ammolytics/ballistic-daq/acquisition/board/acquisition.kicad_pcb

## KiCad design acquisition/board/acquisition.kicad_pcb (2023-02-04)

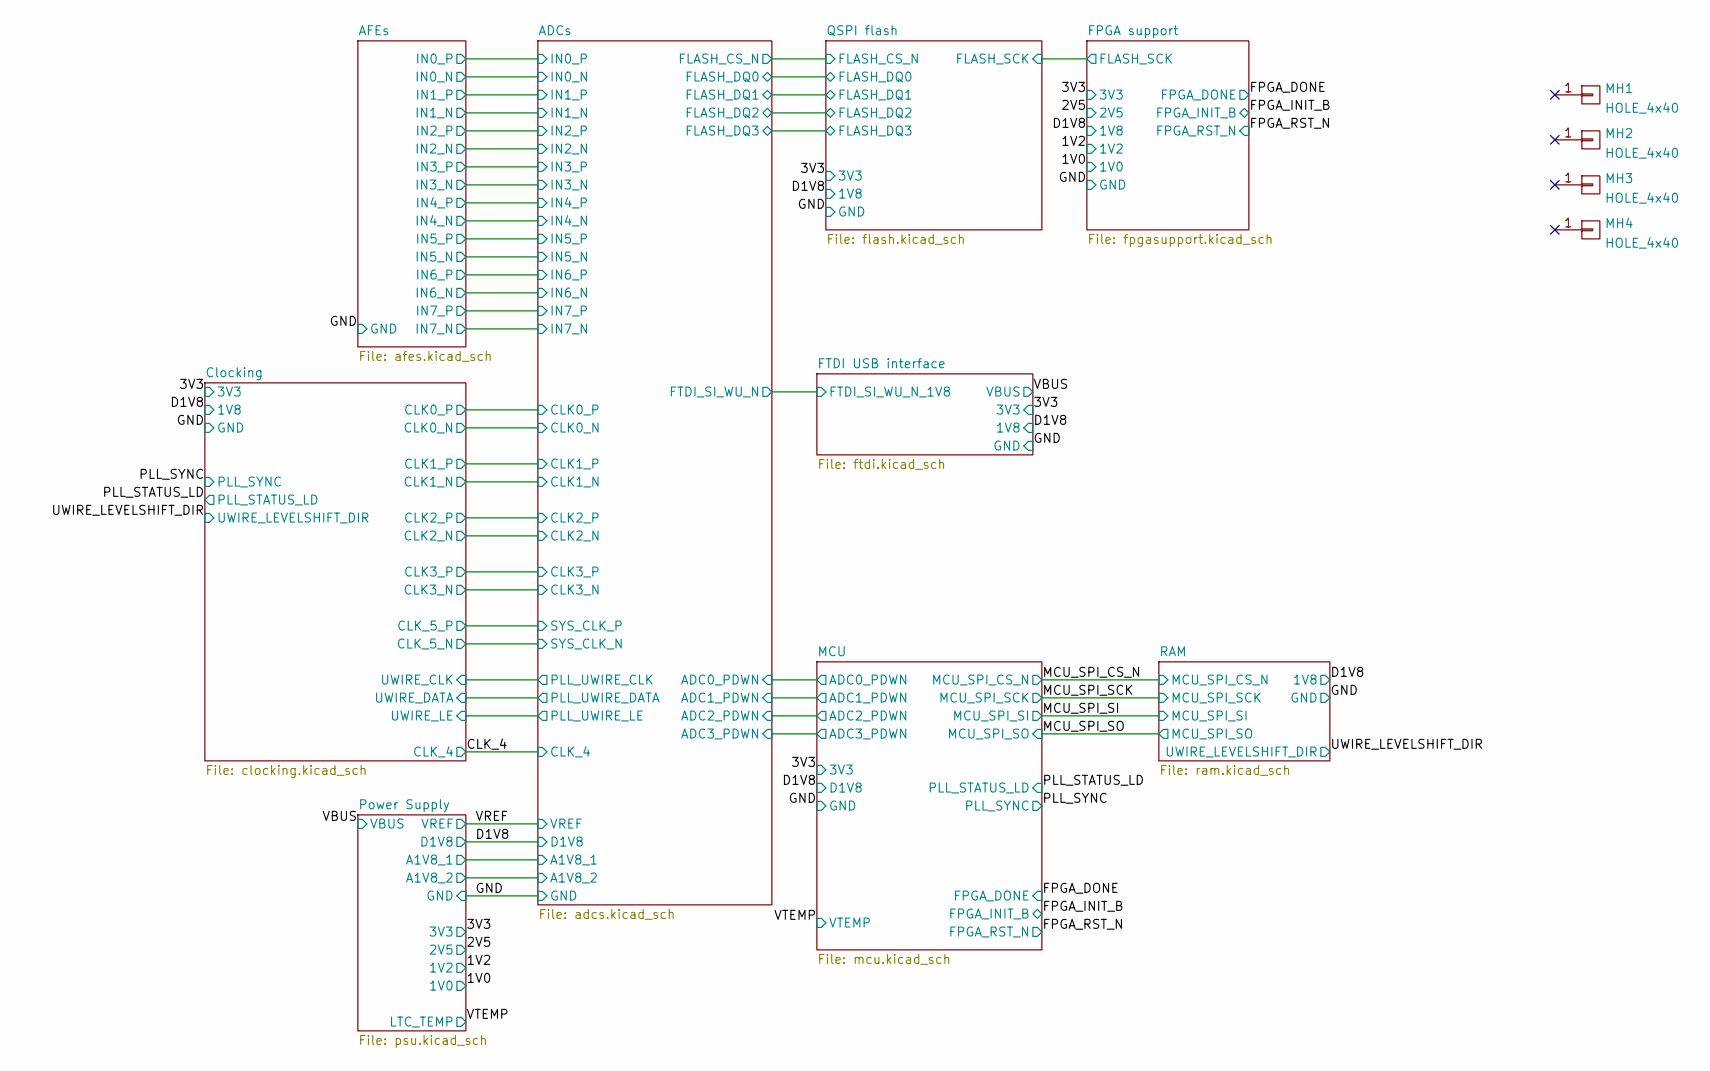
[picture p1: schematic acquisition.kicad_sch, Digitizer board]

Parts:
MH1, MH2, MH3, MH4: HOLE_4x40; MECHANICAL_CLEARANCEHOLE_4_40

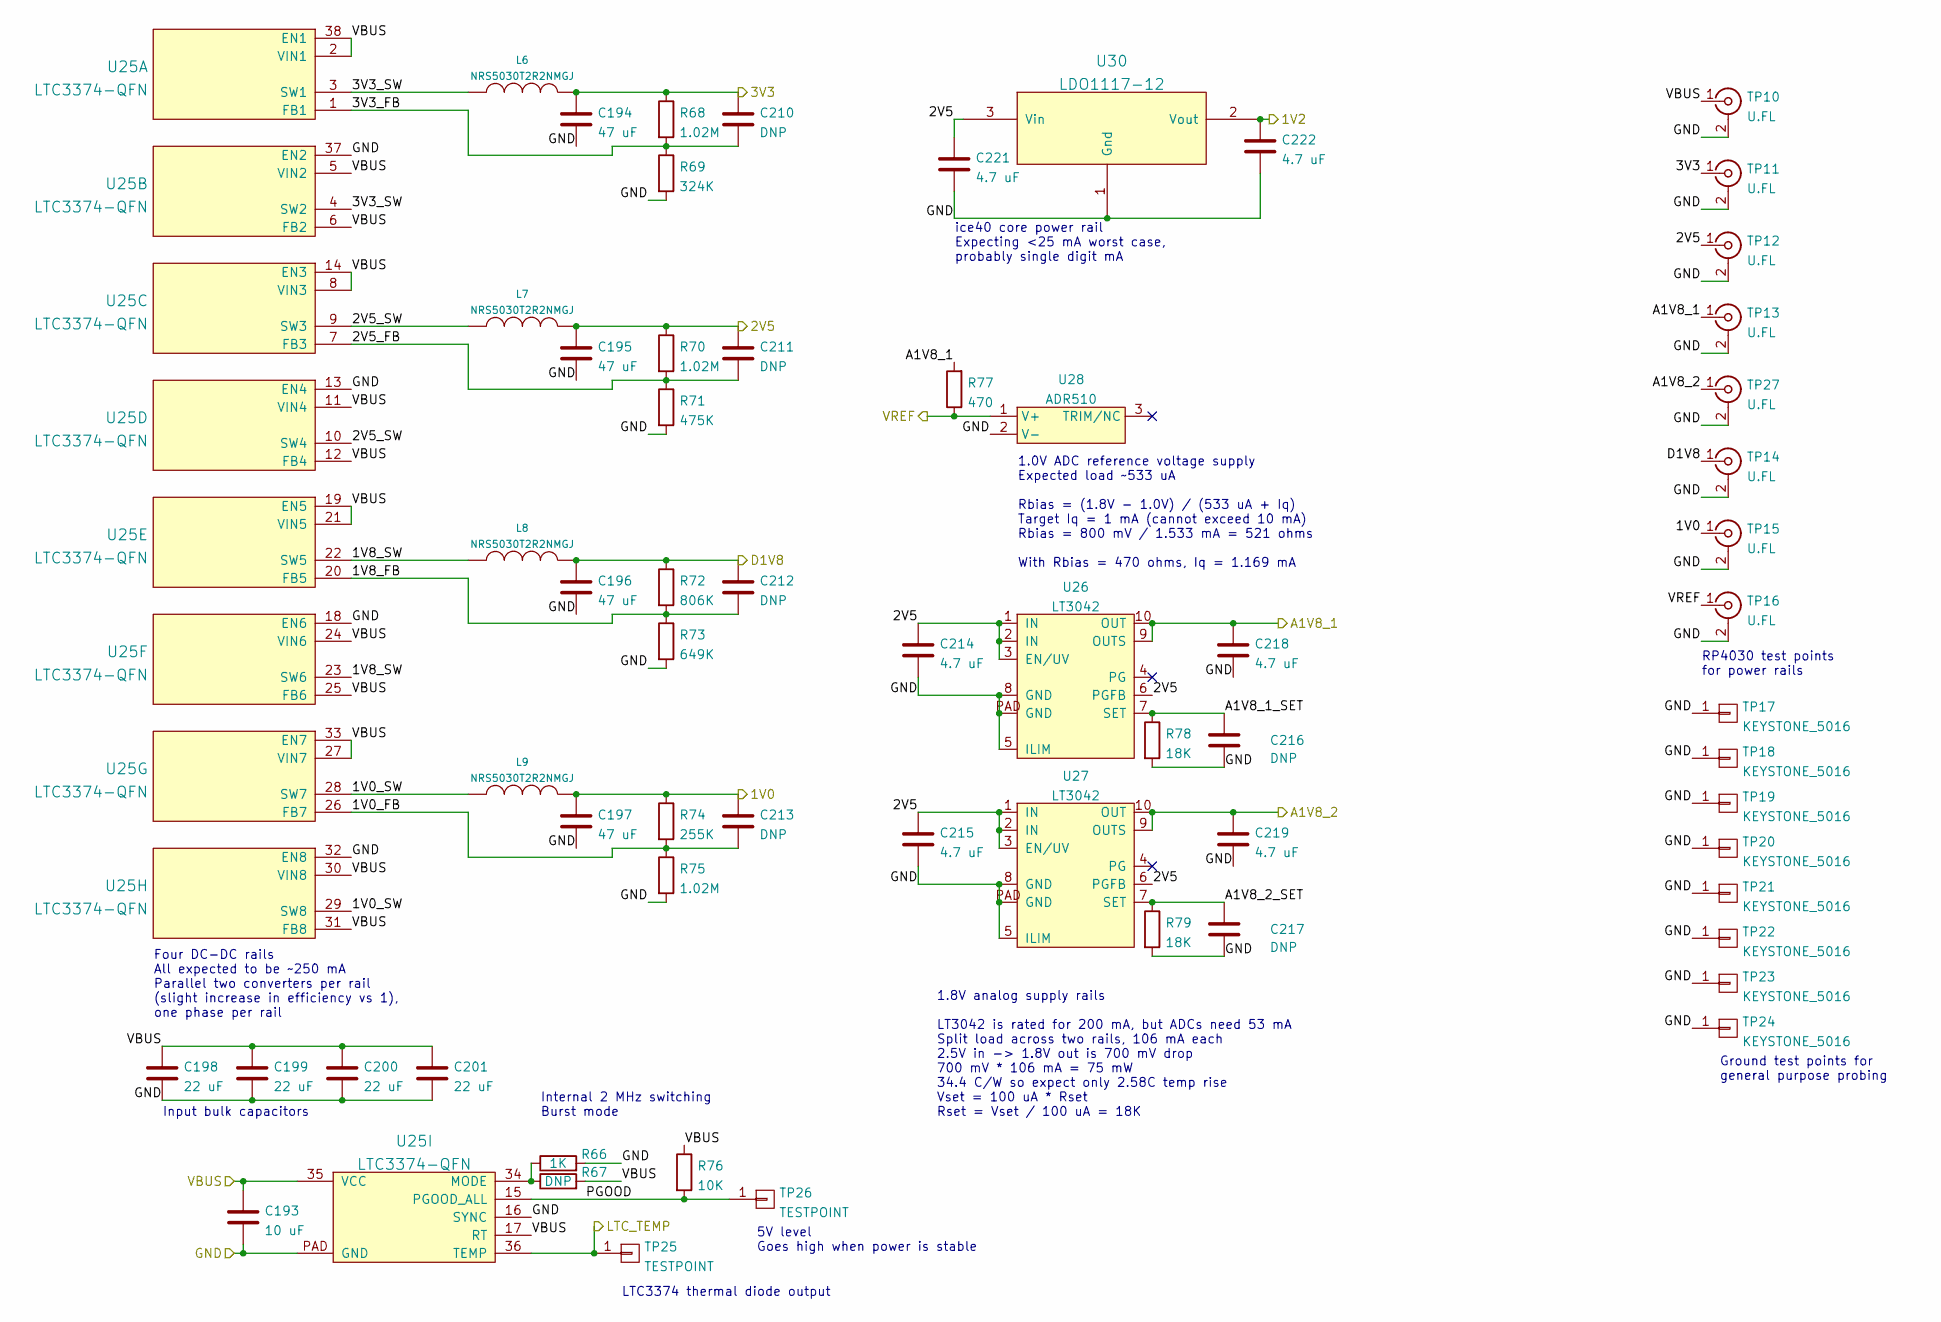
[picture p2: schematic psu.kicad_sch, Digitizer board]

Parts:
C193: 10 uF; EIA_1206_CAP_NOSILK
C194, C195, C196, C197: 47 uF; EIA_1206_CAP_NOSILK
C198, C199, C200, C201: 22 uF; EIA_1210_CAP_NOSILK
C210, C211, C212, C213, C216, C217: DNP; EIA_0402_CAP_NOSILK
C214, C215, C218, C219, C221, C222: 4.7 uF; EIA_0603_CAP_NOSILK
L6, L7, L8, L9: NRS5030T2R2NMGJ; INDUCTOR_YUDEN_NRS5030
R66: 1K; EIA_0402_RES_NOSILK
R67: DNP; EIA_0402_RES_NOSILK
R68, R70, R75: 1.02M; EIA_0402_RES_NOSILK
R69: 324K; EIA_0402_RES_NOSILK
R71: 475K; EIA_0402_RES_NOSILK
R72: 806K; EIA_0402_RES_NOSILK
R73: 649K; EIA_0402_RES_NOSILK
R74: 255K; EIA_0402_RES_NOSILK
R76: 10K; EIA_0402_RES_NOSILK
R77: 470; EIA_0402_RES_NOSILK
R78, R79: 18K; EIA_0402_RES_NOSILK
TP10, TP11, TP12, TP13, TP14, TP15, TP16, TP27: U.FL; CONN_U.FL_TE_1909763-1
TP17, TP18, TP19, TP20, TP21, TP22, TP23, TP24: KEYSTONE_5016; TESTPOINT_SMT_KEYSTONE_5016
TP25, TP26: TESTPOINT; TESTPOINT_SMT_0.5MM
U25: LTC3374-QFN; QFN_38_0.5MM_5x7MM
U26, U27: LT3042; DFN_10_0.5MM_3x3MM
U28: ADR510; SOT23_3
U30: LDO1117-12; SOT223-4

Connections:
/1V0: C197.1, C213.1, L9.1, R74.1, TP15.1 (In); also elsewhere on the board
/1V2: C222.1, U30.2 (Vout); also elsewhere on the board
/2V5: C195.1, C211.1, C214.1, C215.1, C221.1, L7.1, R70.1, TP12.1 (In), U26.1 (IN), U26.2 (IN), U26.3 (EN/UV), U26.6 (PGFB), U27.1 (IN), U27.2 (IN), U27.3 (EN/UV), U27.6 (PGFB), U30.3 (Vin); also elsewhere on the board
/3V3: C194.1, C210.1, L6.1, R68.1, TP11.1 (In); also elsewhere on the board
/ADCs/A1V8_1: C218.1, R77.2, TP13.1 (In), U26.9 (OUTS), U26.10 (OUT); also elsewhere on the board
/ADCs/A1V8_2: C219.1, TP27.1 (In), U27.9 (OUTS), U27.10 (OUT); also elsewhere on the board
/D1V8: C196.1, C212.1, L8.1, R72.1, TP14.1 (In); also elsewhere on the board
/GND: C193.2, C194.2, C195.2, C196.2, C197.2, C198.2, C199.2, C200.2, C201.2, C214.2, C215.2, C216.2, C217.2, C218.2, C219.2, C221.2, C222.2, R66.2, R69.2, R71.2, R73.2, R75.2, R78.2, R79.2, TP10.2 (Ext), TP11.2 (Ext), TP12.2 (Ext), TP13.2 (Ext), TP14.2 (Ext), TP15.2 (Ext), TP16.2 (Ext), TP17.1, TP18.1, TP19.1, TP20.1, TP21.1, TP22.1, TP23.1, TP24.1, TP27.2 (Ext), U25.13 (EN4), U25.16 (SYNC), U25.18 (EN6), U25.32 (EN8), U25.37 (EN2), U25.PAD (GND), U26.5 (ILIM), U26.8 (GND), U26.PAD (GND), U27.5 (ILIM), U27.8 (GND), U27.PAD (GND), U28.2 (V-), U30.1 (Gnd); also elsewhere on the board
/Power Supply/1V0_FB: C213.2, R74.2, R75.1, U25.26 (FB7)
/Power Supply/1V0_SW: L9.2, U25.28 (SW7), U25.29 (SW8)
/Power Supply/1V8_FB: C212.2, R72.2, R73.1, U25.20 (FB5)
/Power Supply/1V8_SW: L8.2, U25.22 (SW5), U25.23 (SW6)
/Power Supply/2V5_FB: C211.2, R70.2, R71.1, U25.7 (FB3)
/Power Supply/2V5_SW: L7.2, U25.9 (SW3), U25.10 (SW4)
/Power Supply/3V3_FB: C210.2, R68.2, R69.1, U25.1 (FB1)
/Power Supply/3V3_SW: L6.2, U25.3 (SW1), U25.4 (SW2)
/Power Supply/A1V8_1_SET: C216.1, R78.1, U26.7 (SET)
/Power Supply/A1V8_2_SET: C217.1, R79.1, U27.7 (SET)
/Power Supply/PGOOD: R76.2, TP26.1, U25.15 (PGOOD_ALL)
/VBUS: C193.1, C198.1, C199.1, C200.1, C201.1, R67.2, R76.1, TP10.1 (In), U25.2 (VIN1), U25.5 (VIN2), U25.6 (FB2), U25.8 (VIN3), U25.11 (VIN4), U25.12 (FB4), U25.14 (EN3), U25.17 (RT), U25.19 (EN5), U25.21 (VIN5), U25.24 (VIN6), U25.25 (FB6), U25.27 (VIN7), U25.30 (VIN8), U25.31 (FB8), U25.33 (EN7), U25.35 (VCC), U25.38 (EN1); also elsewhere on the board
/VREF: R77.1, TP16.1 (In), U28.1 (V+); also elsewhere on the board
/VTEMP: TP25.1, U25.36 (TEMP); also elsewhere on the board
unnamed: R66.1, R67.1, U25.34 (MODE)

Notes on the sheet:
ice40 core power rail Expecting <25 mA worst case, probably single digit mA
LTC3374 thermal diode output
Ground test points for general purpose probing
5V level Goes high when power is stable
Input bulk capacitors
1.8V analog supply rails LT3042 is rated for 200 mA, but ADCs need 53 mA Split load across two rails, 106 mA each 2.5V in -> 1.8V out is 700 mV drop 700 mV * 106 mA = 75 mW 34.4 C/W so expect only 2.58C temp rise Vset = 100 uA * Rset Rset = Vset / 100 uA = 18K
Internal 2 MHz switching Burst mode
RP4030 test points for power rails
Four DC-DC rails All expected to be ~250 mA Parallel two converters per rail (slight increase in efficiency vs 1), one phase per rail
1.0V ADC reference voltage supply Expected load ~533 uA Rbias = (1.8V - 1.0V) / (533 uA + Iq) Target Iq = 1 mA (cannot exceed 10 mA) Rbias = 800 mV / 1.533 mA = 521 ohms With Rbias = 470 ohms, Iq = 1.169 mA

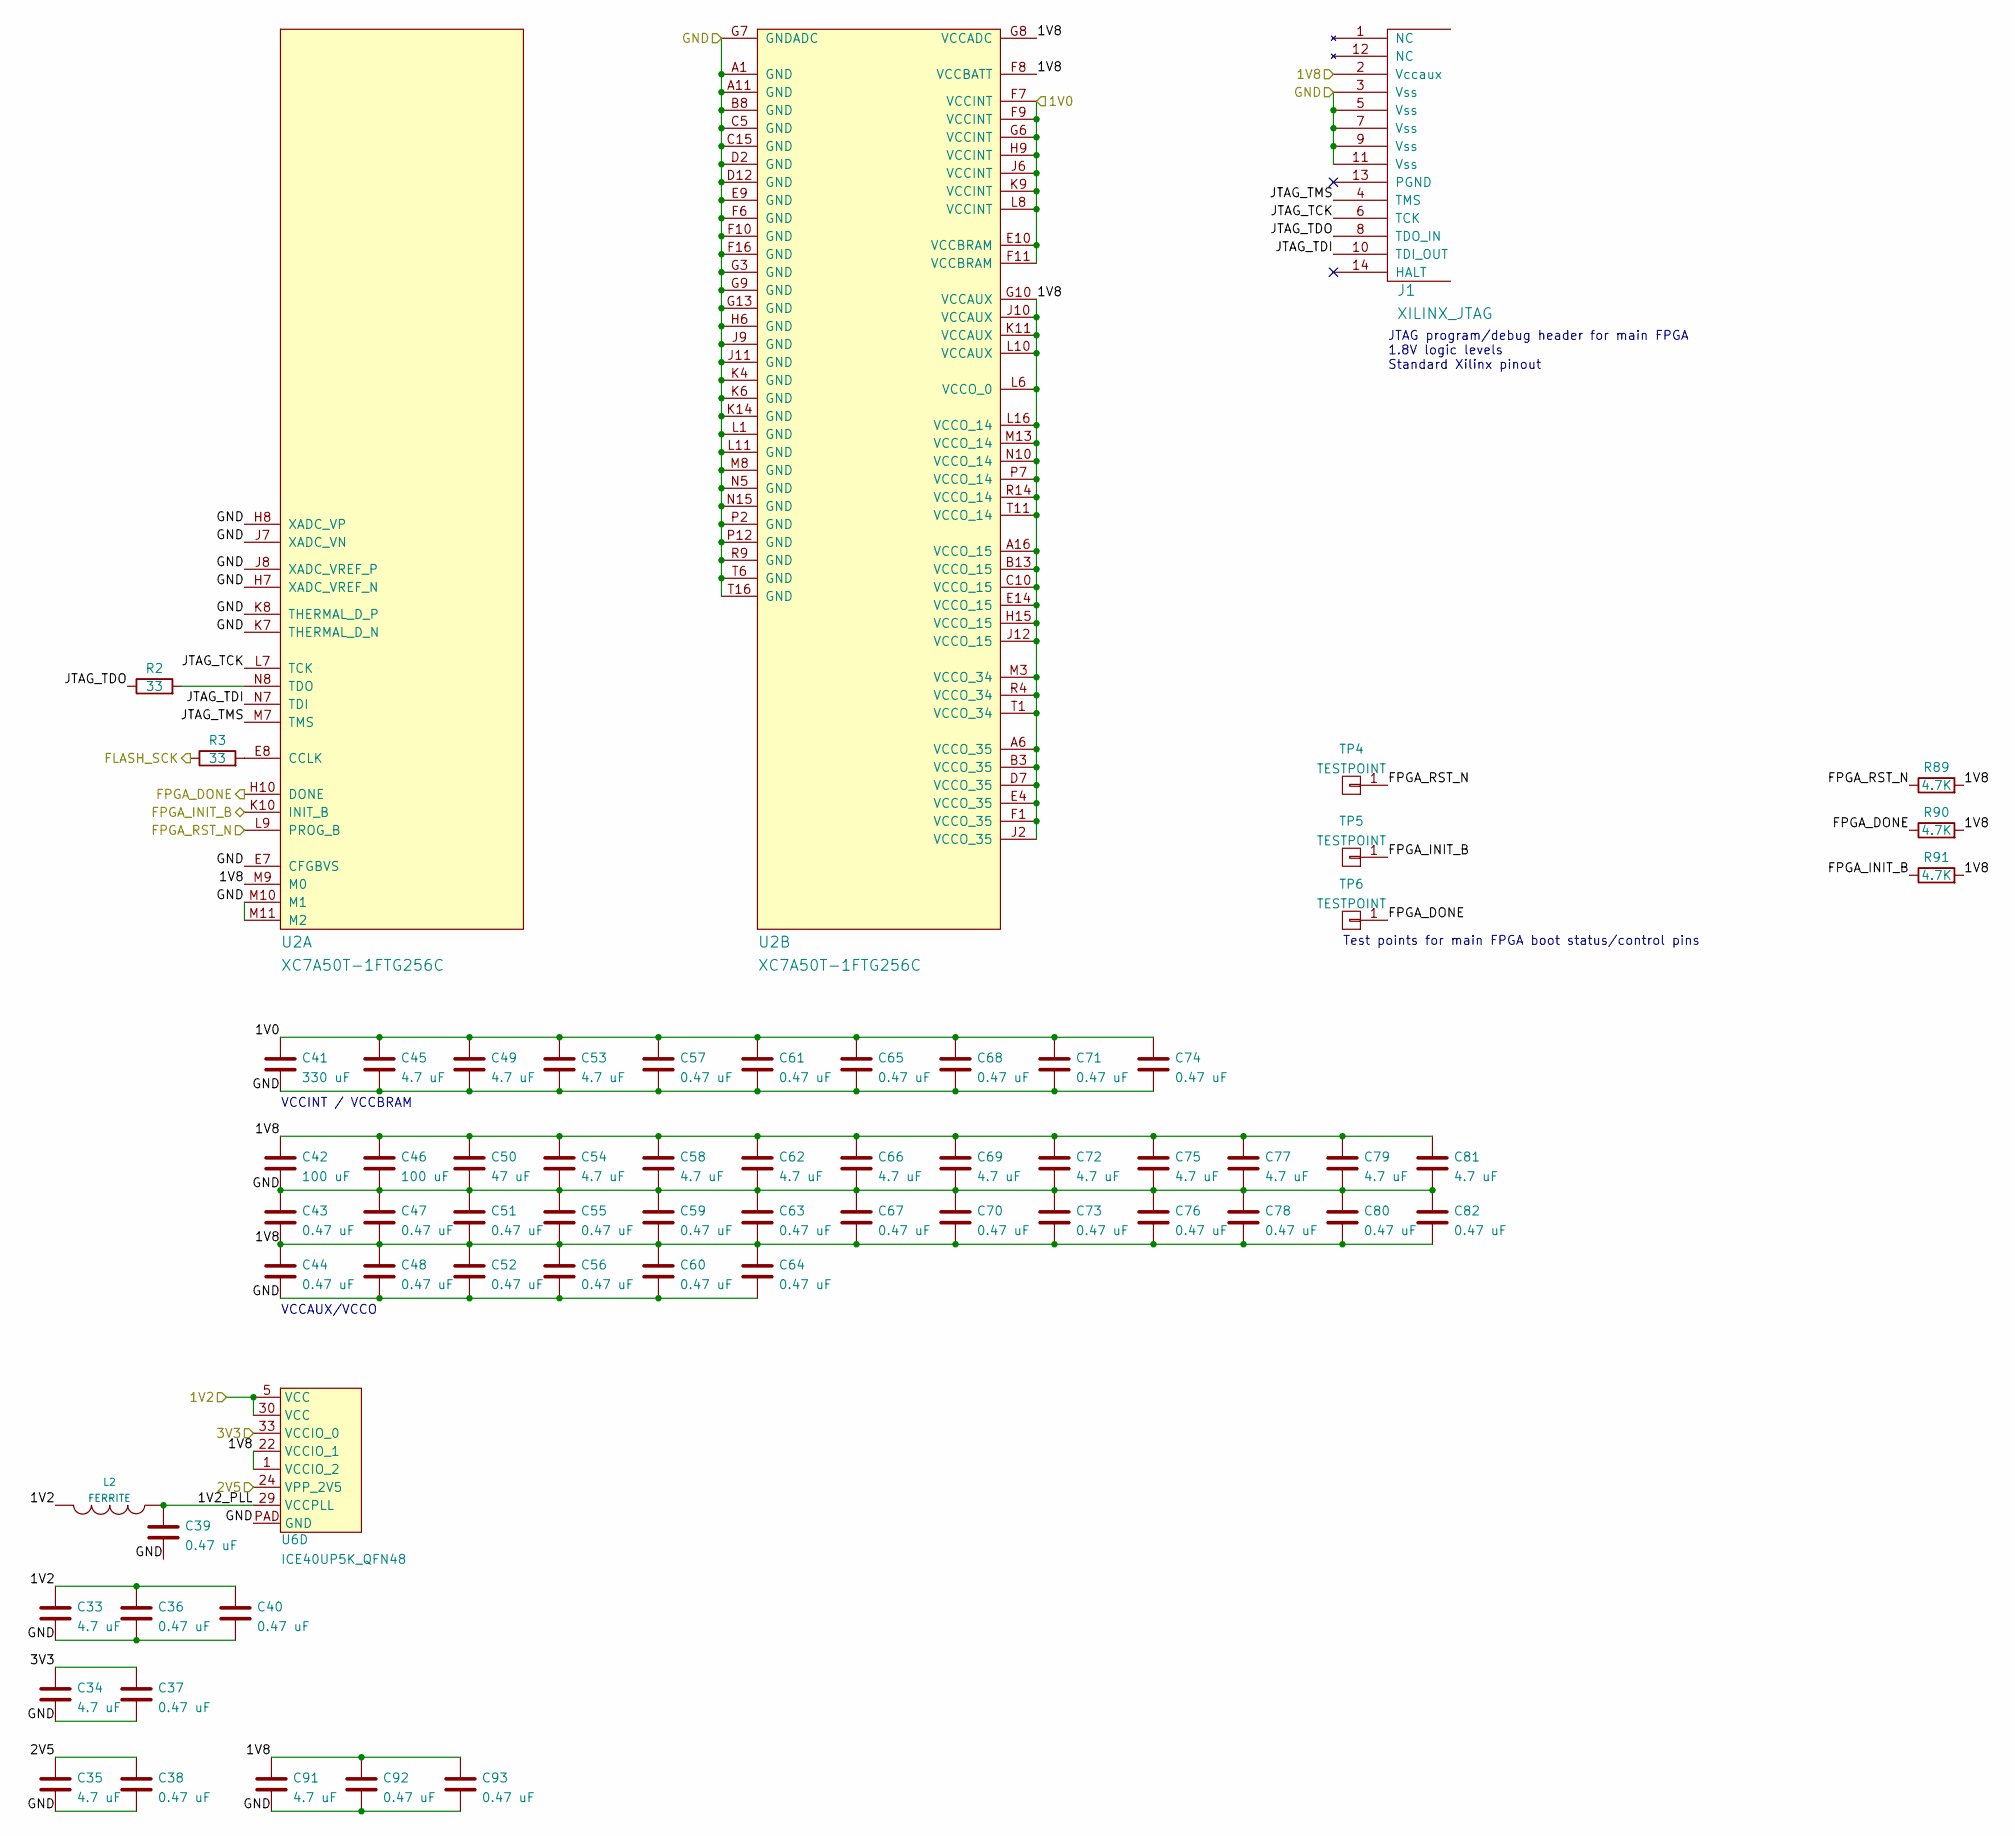
[picture p3: schematic fpgasupport.kicad_sch, Digitizer board]

Parts:
C33, C34, C35, C45, C49, C53, C54, C58, C62, C66, C69, C72, C75, C77, C79, C81, C91: 4.7 uF; EIA_0603_CAP_NOSILK
C36, C37, C38, C39, C40, C43, C44, C47, C48, C51, C52, C55, C56, C57, C59, C60, C61, C63, C64, C65, C67, C68, C70, C71, C73, C74, C76, C78, C80, C82, C92, C93: 0.47 uF; EIA_0402_CAP_NOSILK
C41: 330 uF; EIA_1210_CAP_NOSILK
C42, C46: 100 uF; EIA_1206_CAP_NOSILK
C50: 47 uF; EIA_1210_CAP_NOSILK
J1: XILINX_JTAG; XILINX_JTAG_PTH_MOLEX_0878311420
L2: FERRITE; EIA_0603_INDUCTOR_NOSILK
R2, R3: 33; EIA_0402_RES_NOSILK
R89, R90, R91: 4.7K; EIA_0402_RES_NOSILK
TP4, TP5, TP6: TESTPOINT; TESTPOINT_SMT_0.5MM
U2: XC7A50T-1FTG256C; BGA_256_17x17_FULLARRAY_1MM_0.4MM_FTG256
U6: ICE40UP5K_QFN48; QFN_48_0.5MM_7x7MM

Connections:
/1V0: C41.1, C45.1, C49.1, C53.1, C57.1, C61.1, C65.1, C68.1, C71.1, C74.1, U2.E10 (VCCBRAM), U2.F7 (VCCINT), U2.F9 (VCCINT), U2.F11 (VCCBRAM), U2.G6 (VCCINT), U2.H9 (VCCINT), U2.J6 (VCCINT), U2.K9 (VCCINT), U2.L8 (VCCINT); also elsewhere on the board
/1V2: C33.1, C36.1, C40.1, L2.2, U6.5 (VCC), U6.30 (VCC); also elsewhere on the board
/2V5: C35.1, C38.1, U6.24 (VPP_2V5); also elsewhere on the board
/3V3: C34.1, C37.1, U6.33 (VCCIO_0); also elsewhere on the board
/D1V8: C42.1, C43.2, C44.1, C46.1, C47.2, C48.1, C50.1, C51.2, C52.1, C54.1, C55.2, C56.1, C58.1, C59.2, C60.1, C62.1, C63.2, C64.1, C66.1, C67.2, C69.1, C70.2, C72.1, C73.2, C75.1, C76.2, C77.1, C78.2, C79.1, C80.2, C81.1, C82.2, C91.1, C92.1, C93.1, J1.2 (Vccaux), R89.2, R90.2, R91.2, U2.A6 (VCCO_35), U2.A16 (VCCO_15), U2.B3 (VCCO_35), U2.B13 (VCCO_15), U2.C10 (VCCO_15), U2.D7 (VCCO_35), U2.E4 (VCCO_35), U2.E14 (VCCO_15), U2.F1 (VCCO_35), U2.F8 (VCCBATT), U2.G8 (VCCADC), U2.G10 (VCCAUX), U2.H15 (VCCO_15), U2.J2 (VCCO_35), U2.J10 (VCCAUX), U2.J12 (VCCO_15), U2.K11 (VCCAUX), U2.L6 (VCCO_0), U2.L10 (VCCAUX), U2.L16 (VCCO_14), U2.M3 (VCCO_34), U2.M9 (M0), U2.M13 (VCCO_14), U2.N10 (VCCO_14), U2.P7 (VCCO_14), U2.R4 (VCCO_34), U2.R14 (VCCO_14), U2.T1 (VCCO_34), U2.T11 (VCCO_14), U6.1 (VCCIO_2), U6.22 (VCCIO_1); also elsewhere on the board
/FPGA support/1V2_PLL: C39.1, L2.1, U6.29 (VCCPLL)
/FPGA support/FLASH_SCK: R3.1; also elsewhere on the board
/FPGA support/JTAG_TCK: J1.6 (TCK), U2.L7 (TCK)
/FPGA support/JTAG_TDI: J1.10 (TDI_OUT), U2.N7 (TDI)
/FPGA support/JTAG_TDO: J1.8 (TDO_IN), R2.1
/FPGA support/JTAG_TMS: J1.4 (TMS), U2.M7 (TMS)
/FPGA_DONE: R90.1, TP6.1, U2.H10 (DONE); also elsewhere on the board
/FPGA_INIT_B: R91.1, TP5.1, U2.K10 (INIT_B); also elsewhere on the board
/FPGA_RST_N: R89.1, TP4.1, U2.L9 (PROG_B); also elsewhere on the board
/GND: C33.2, C34.2, C35.2, C36.2, C37.2, C38.2, C39.2, C40.2, C41.2, C42.2, C43.1, C44.2, C45.2, C46.2, C47.1, C48.2, C49.2, C50.2, C51.1, C52.2, C53.2, C54.2, C55.1, C56.2, C57.2, C58.2, C59.1, C60.2, C61.2, C62.2, C63.1, C64.2, C65.2, C66.2, C67.1, C68.2, C69.2, C70.1, C71.2, C72.2, C73.1, C74.2, C75.2, C76.1, C77.2, C78.1, C79.2, C80.1, C81.2, C82.1, C91.2, C92.2, C93.2, J1.3 (Vss), J1.5 (Vss), J1.7 (Vss), J1.9 (Vss), J1.11 (Vss), U2.A1 (GND), U2.A11 (GND), U2.B8 (GND), U2.C5 (GND), U2.C15 (GND), U2.D2 (GND), U2.D12 (GND), U2.E7 (CFGBVS), U2.E9 (GND), U2.F6 (GND), U2.F10 (GND), U2.F16 (GND), U2.G3 (GND), U2.G7 (GNDADC), U2.G9 (GND), U2.G13 (GND), U2.H6 (GND), U2.H7 (XADC_VREF_N), U2.H8 (XADC_VP), U2.J7 (XADC_VN), U2.J8 (XADC_VREF_P), U2.J9 (GND), U2.J11 (GND), U2.K4 (GND), U2.K6 (GND), U2.K7 (THERMAL_D_N), U2.K8 (THERMAL_D_P), U2.K14 (GND), U2.L1 (GND), U2.L11 (GND), U2.M8 (GND), U2.M10 (M1), U2.M11 (M2), U2.N5 (GND), U2.N15 (GND), U2.P2 (GND), U2.P12 (GND), U2.R9 (GND), U2.T6 (GND), U2.T16 (GND), U6.PAD (GND); also elsewhere on the board
unnamed: R2.2, U2.N8 (TDO)
unnamed: R3.2, U2.E8 (CCLK)

Notes on the sheet:
JTAG program/debug header for main FPGA 1.8V logic levels Standard Xilinx pinout
Test points for main FPGA boot status/control pins
VCCINT / VCCBRAM
VCCAUX/VCCO

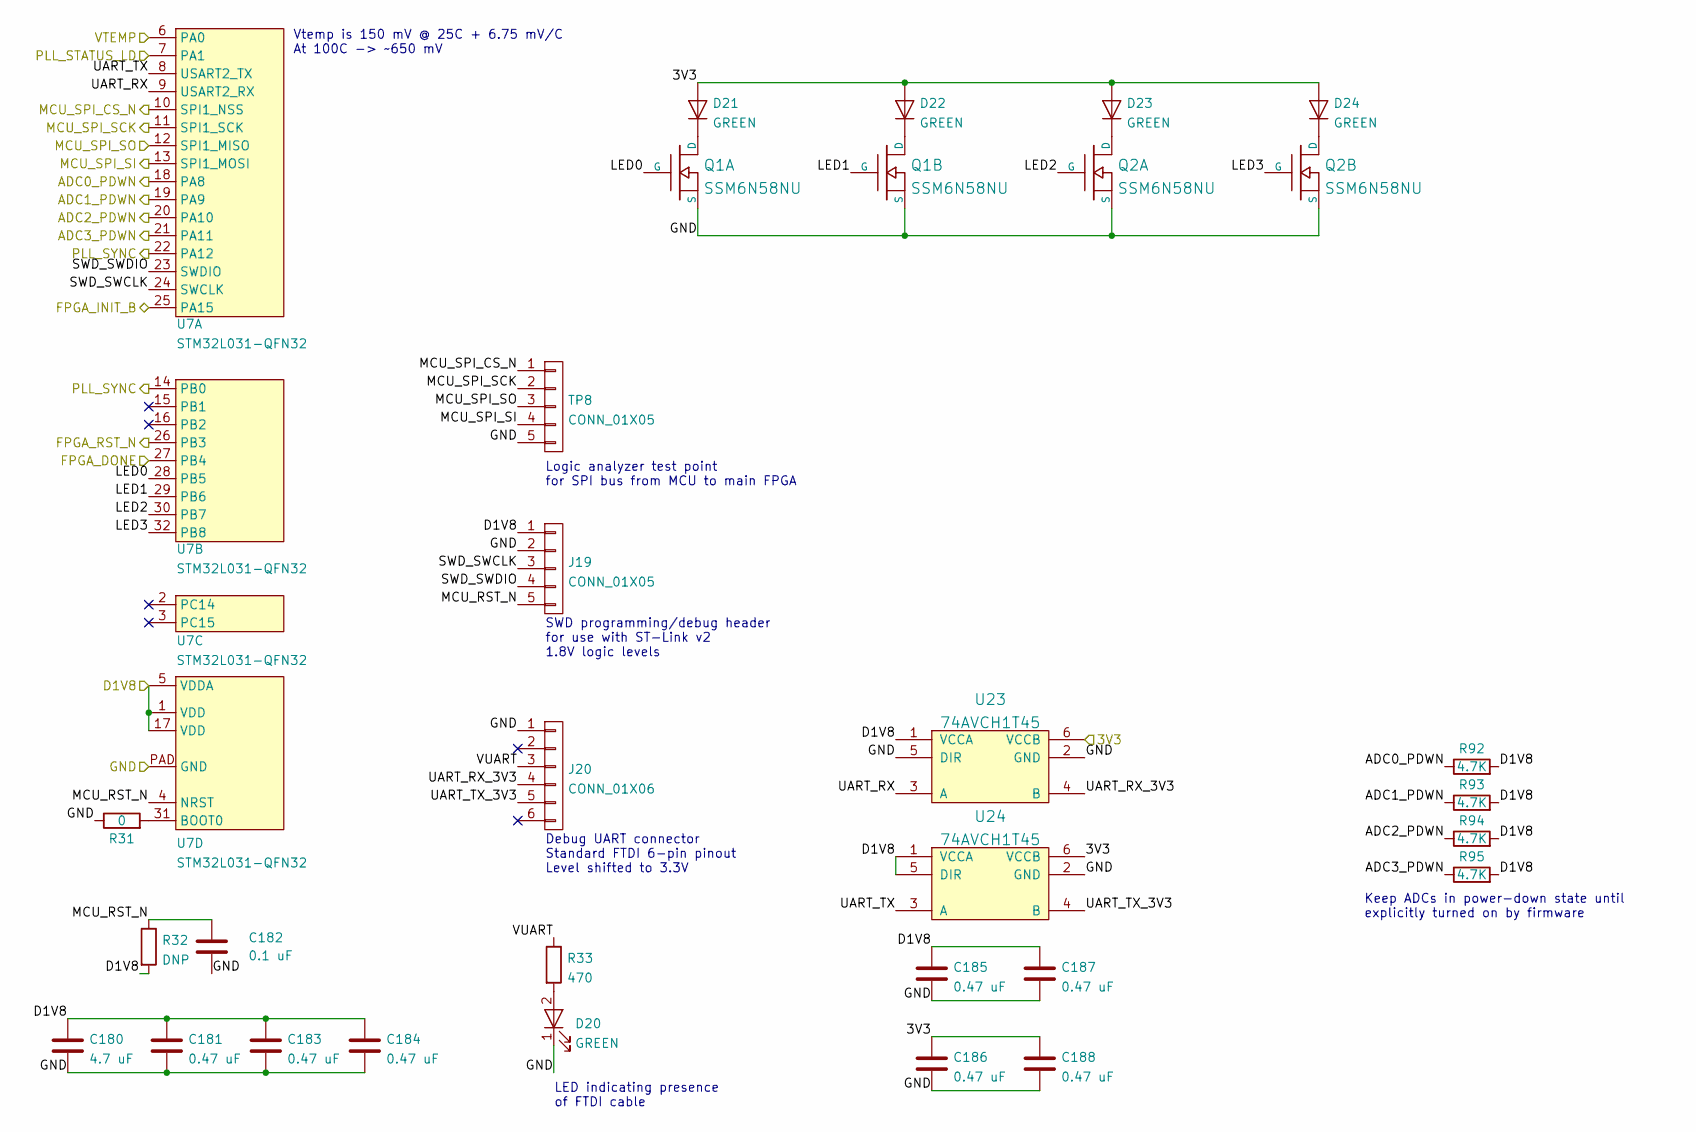
[picture p4: schematic mcu.kicad_sch, Digitizer board]

Parts:
C180: 4.7 uF; EIA_0603_CAP_NOSILK
C181, C183, C184, C185, C186, C187, C188: 0.47 uF; EIA_0402_CAP_NOSILK
C182: 0.1 uF; EIA_0402_CAP_NOSILK
D20, D21, D22, D23, D24: GREEN; EIA_0603_LED
J19: CONN_01X05; CONN_HEADER_2.54MM_1x5
J20: CONN_01X06; CONN_HEADER_2.54MM_1x6
Q1, Q2: SSM6N58NU; DFN_6_0.65MM_2x2MM_GDS
R31: 0; EIA_0402_RES_NOSILK
R32: DNP; EIA_0402_RES_NOSILK
R33: 470; EIA_0402_RES_NOSILK
R92, R93, R94, R95: 4.7K; EIA_0402_RES_NOSILK
TP8: CONN_01X05; CONN_HEADER_2.54MM_1x5
U7: STM32L031-QFN32; QFN_32_0.5MM_5x5MM
U23, U24: 74AVCH1T45; DFN_6_0.5MM_1.45x1.00MM

Connections:
/3V3: C186.1, C188.1, D21.2 (A), D22.2 (A), D23.2 (A), D24.2 (A), U23.6 (VCCB), U24.6 (VCCB); also elsewhere on the board
/D1V8: C180.1, C181.1, C183.1, C184.1, C185.1, C187.1, J19.1, R32.2, R92.2, R93.2, R94.2, R95.2, U7.1 (VDD), U7.5 (VDDA), U7.17 (VDD), U23.1 (VCCA), U24.1 (VCCA), U24.5 (DIR); also elsewhere on the board
/FPGA_DONE: U7.27 (PB4); also elsewhere on the board
/FPGA_INIT_B: U7.25 (PA15); also elsewhere on the board
/FPGA_RST_N: U7.26 (PB3); also elsewhere on the board
/GND: C180.2, C181.2, C182.2, C183.2, C184.2, C185.2, C186.2, C187.2, C188.2, D20.1 (K), J19.2, J20.1, Q1.S1 (S), Q1.S2 (S), Q2.S1 (S), Q2.S2 (S), R31.1, TP8.5, U7.PAD (GND), U23.2 (GND), U23.5 (DIR), U24.2 (GND); also elsewhere on the board
/MCU/ADC0_PDWN: R92.1, U7.18 (PA8); also elsewhere on the board
/MCU/ADC1_PDWN: R93.1, U7.19 (PA9); also elsewhere on the board
/MCU/ADC2_PDWN: R94.1, U7.20 (PA10); also elsewhere on the board
/MCU/ADC3_PDWN: R95.1, U7.21 (PA11); also elsewhere on the board
/MCU/LED0: Q1.G1 (G), U7.28 (PB5)
/MCU/LED1: Q1.G2 (G), U7.29 (PB6)
/MCU/LED2: Q2.G1 (G), U7.30 (PB7)
/MCU/LED3: Q2.G2 (G), U7.32 (PB8)
/MCU/MCU_RST_N: C182.1, J19.5, R32.1, U7.4 (NRST)
/MCU/SWD_SWCLK: J19.3, U7.24 (SWCLK)
/MCU/SWD_SWDIO: J19.4, U7.23 (SWDIO)
/MCU/UART_RX: U7.9 (USART2_RX), U23.3 (A)
/MCU/UART_RX_3V3: J20.4, U23.4 (B)
/MCU/UART_TX: U7.8 (USART2_TX), U24.3 (A)
/MCU/UART_TX_3V3: J20.5, U24.4 (B)
/MCU/VUART: J20.3, R33.1
/MCU_SPI_CS_N: TP8.1, U7.10 (SPI1_NSS); also elsewhere on the board
/MCU_SPI_SCK: TP8.2, U7.11 (SPI1_SCK); also elsewhere on the board
/MCU_SPI_SI: TP8.4, U7.13 (SPI1_MOSI); also elsewhere on the board
/MCU_SPI_SO: TP8.3, U7.12 (SPI1_MISO); also elsewhere on the board
/PLL_STATUS_LD: U7.7 (PA1); also elsewhere on the board
/PLL_SYNC: U7.14 (PB0), U7.22 (PA12); also elsewhere on the board
/VTEMP: U7.6 (PA0); also elsewhere on the board
unnamed: D20.2 (A), R33.2
unnamed: D21.1 (K), Q1.D1 (D)
unnamed: D22.1 (K), Q1.D2 (D)
unnamed: D23.1 (K), Q2.D1 (D)
unnamed: D24.1 (K), Q2.D2 (D)
unnamed: R31.2, U7.31 (BOOT0)

Notes on the sheet:
Keep ADCs in power-down state until explicitly turned on by firmware
SWD programming/debug header for use with ST-Link v2 1.8V logic levels
Debug UART connector Standard FTDI 6-pin pinout Level shifted to 3.3V
Logic analyzer test point for SPI bus from MCU to main FPGA
LED indicating presence of FTDI cable
Vtemp is 150 mV @ 25C + 6.75 mV/C At 100C -> ~650 mV
