ammolytics/ballistic-daq/acquisition/board/acquisition.kicad_pcb

## KiCad design acquisition/board/acquisition.kicad_pcb (continued)

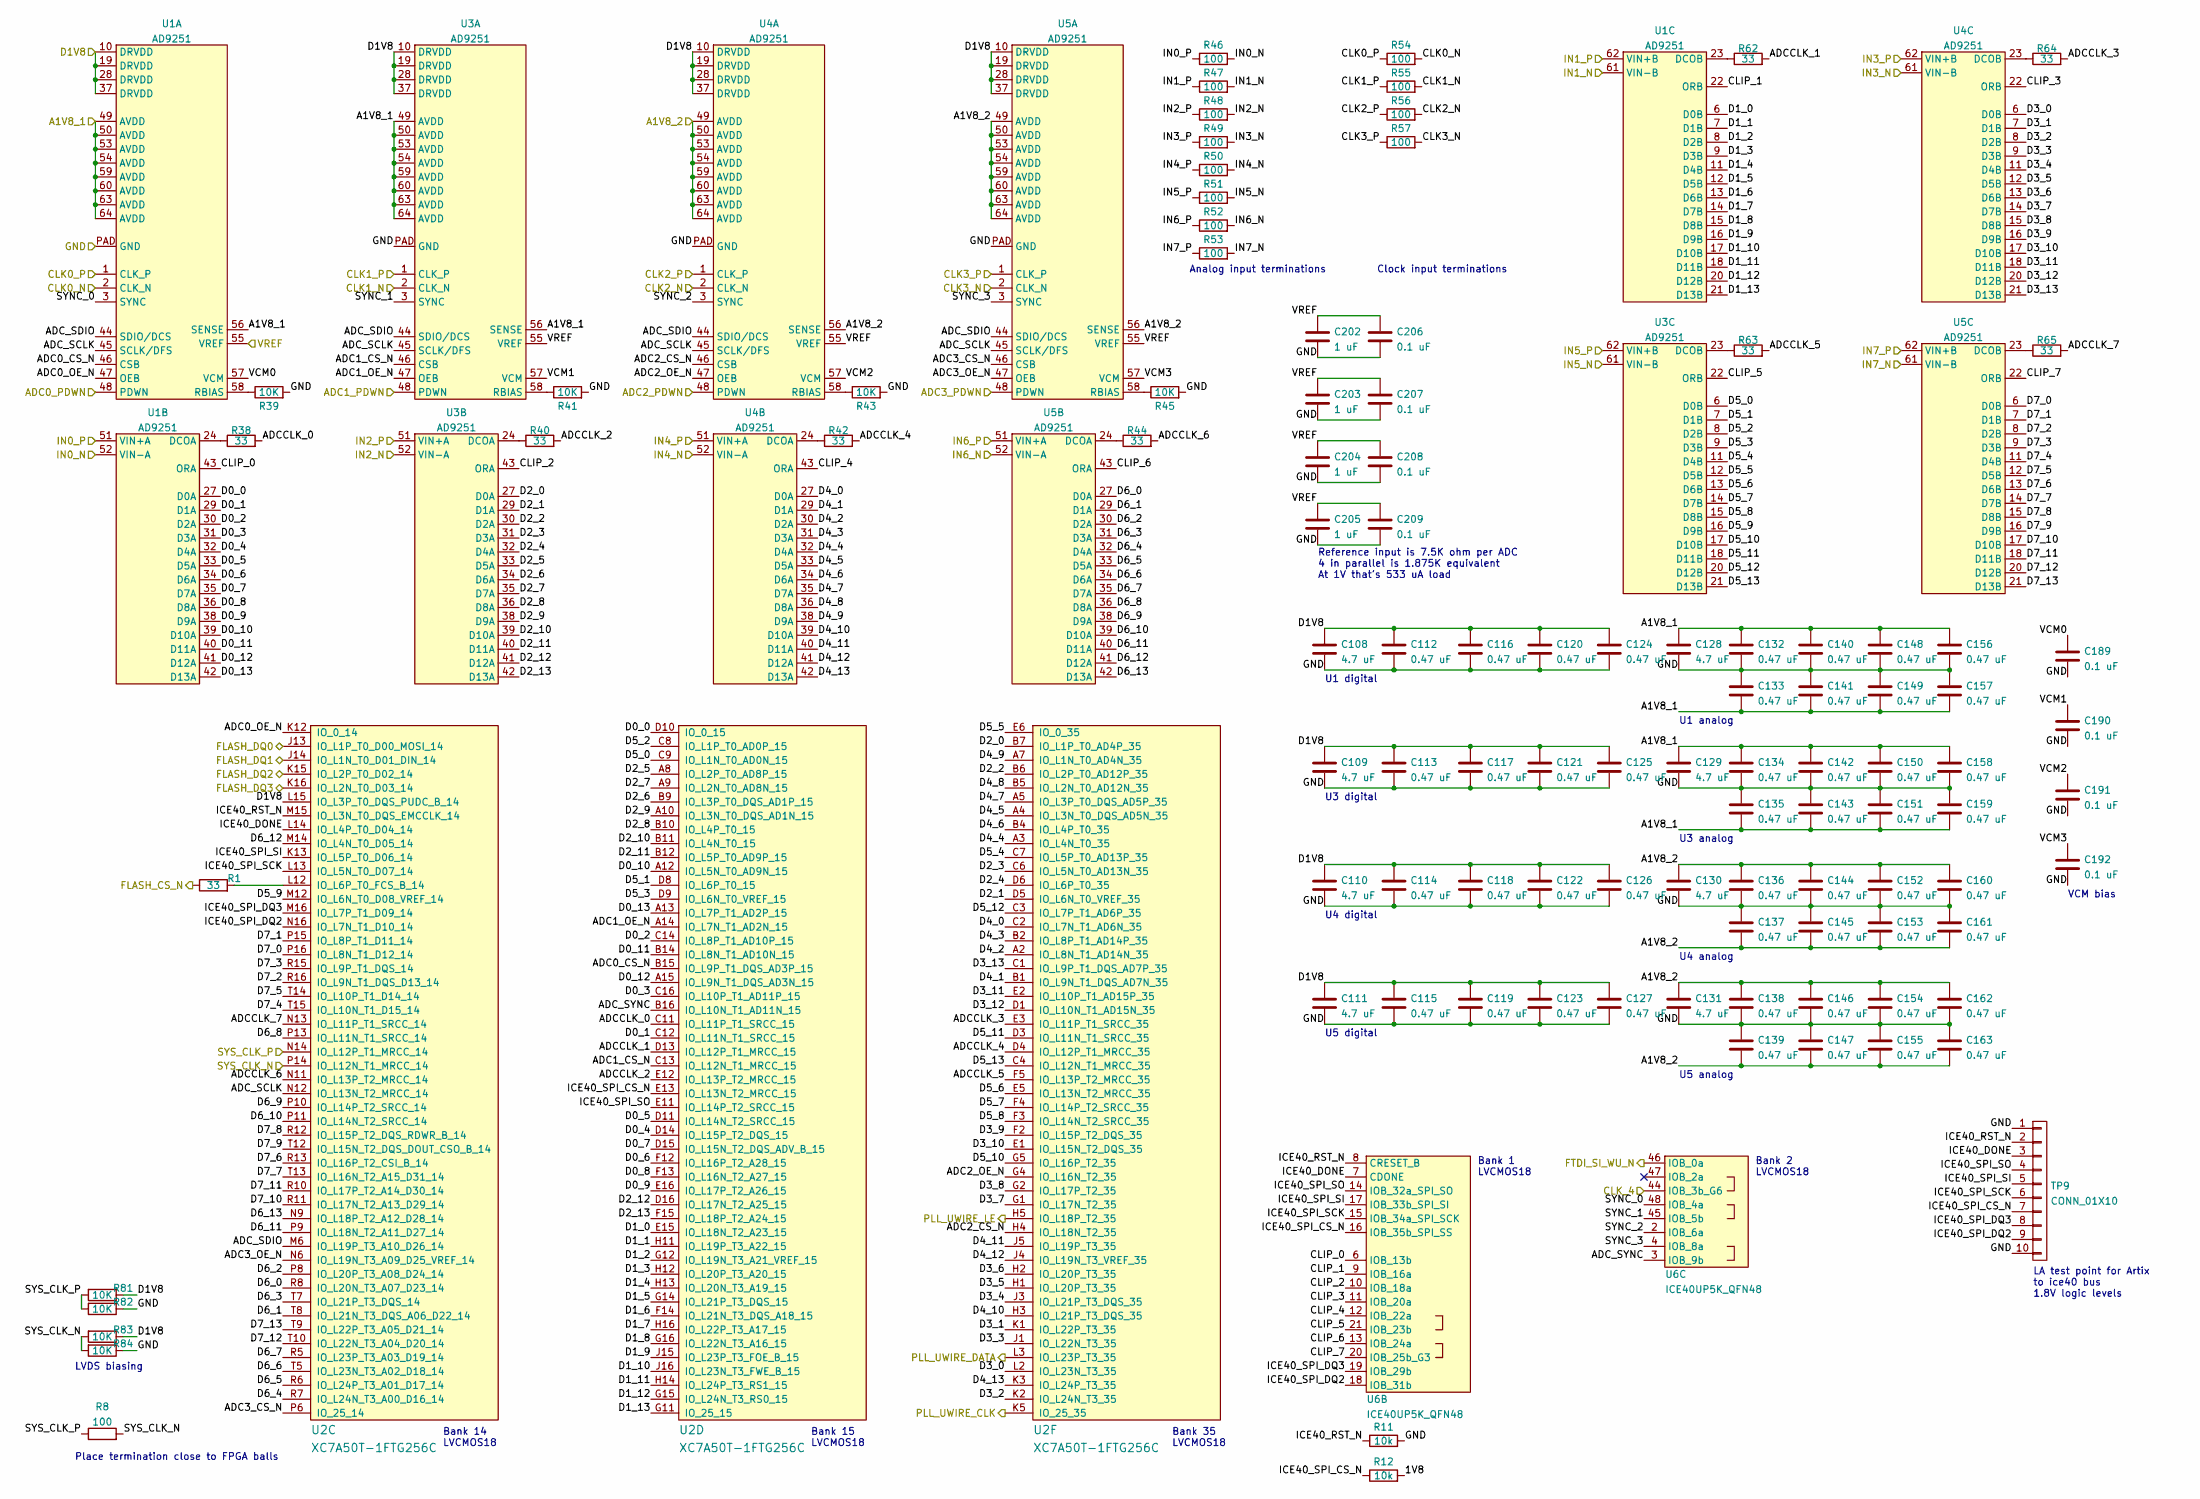
[picture p5: schematic adcs.kicad_sch, Digitizer board]

Parts:
C108, C109, C110, C111, C128, C129, C130, C131: 4.7 uF; EIA_0603_CAP_NOSILK
C112, C113, C114, C115, C116, C117, C118, C119, C120, C121, C122, C123, C124, C125, C126, C127, C132, C133, C134, C135, C136, C137, C138, C139, C140, C141, C142, C143, C144, C145, C146, C147, C148, C149, C150, C151, C152, C153, C154, C155, C156, C157, C158, C159, C160, C161, C162, C163: 0.47 uF; EIA_0402_CAP_NOSILK
C189, C190, C191, C192, C206, C207, C208, C209: 0.1 uF; EIA_0402_CAP_NOSILK
C202, C203, C204, C205: 1 uF; EIA_0603_CAP_NOSILK
R1, R38, R40, R42, R44, R62, R63, R64, R65: 33; EIA_0402_RES_NOSILK
R8, R46, R47, R48, R49, R50, R51, R52, R53, R54, R55, R56, R57: 100; EIA_0402_RES_NOSILK
R11, R12: 10k; EIA_0402_RES_NOSILK
R39, R41, R43, R45, R81, R82, R83, R84: 10K; EIA_0402_RES_NOSILK
TP9: CONN_01X10; CONN_HEADER_2.54MM_1x10
U1, U3, U4, U5: AD9251; QFN_64_0.5MM_9x9MM
U2: XC7A50T-1FTG256C; BGA_256_17x17_FULLARRAY_1MM_0.4MM_FTG256
U6: ICE40UP5K_QFN48; QFN_48_0.5MM_7x7MM

Connections:
/ADCs/1V8: R12.2
/ADCs/A1V8_1: C128.1, C129.1, C132.1, C133.2, C134.1, C135.2, C140.1, C141.2, C142.1, C143.2, C148.1, C149.2, C150.1, C151.2, C156.1, C157.2, C158.1, C159.2, U1.49 (AVDD), U1.50 (AVDD), U1.53 (AVDD), U1.54 (AVDD), U1.56 (SENSE), U1.59 (AVDD), U1.60 (AVDD), U1.63 (AVDD), U1.64 (AVDD), U3.49 (AVDD), U3.50 (AVDD), U3.53 (AVDD), U3.54 (AVDD), U3.56 (SENSE), U3.59 (AVDD), U3.60 (AVDD), U3.63 (AVDD), U3.64 (AVDD); also elsewhere on the board
/ADCs/A1V8_2: C130.1, C131.1, C136.1, C137.2, C138.1, C139.2, C144.1, C145.2, C146.1, C147.2, C152.1, C153.2, C154.1, C155.2, C160.1, C161.2, C162.1, C163.2, U4.49 (AVDD), U4.50 (AVDD), U4.53 (AVDD), U4.54 (AVDD), U4.56 (SENSE), U4.59 (AVDD), U4.60 (AVDD), U4.63 (AVDD), U4.64 (AVDD), U5.49 (AVDD), U5.50 (AVDD), U5.53 (AVDD), U5.54 (AVDD), U5.56 (SENSE), U5.59 (AVDD), U5.60 (AVDD), U5.63 (AVDD), U5.64 (AVDD); also elsewhere on the board
/ADCs/ADC0_CS_N: U1.46 (CSB), U2.B15 (IO_L9P_T1_DQS_AD3P_15)
/ADCs/ADC0_OE_N: U1.47 (OEB), U2.K12 (IO_0_14)
/ADCs/ADC1_CS_N: U2.C13 (IO_L12N_T1_MRCC_15), U3.46 (CSB)
/ADCs/ADC1_OE_N: U2.A14 (IO_L7N_T1_AD2N_15), U3.47 (OEB)
/ADCs/ADC2_CS_N: U2.H4 (IO_L18N_T2_35), U4.46 (CSB)
/ADCs/ADC2_OE_N: U2.G4 (IO_L16N_T2_35), U4.47 (OEB)
/ADCs/ADC3_CS_N: U2.P6 (IO_25_14), U5.46 (CSB)
/ADCs/ADC3_OE_N: U2.N6 (IO_L19N_T3_A09_D25_VREF_14), U5.47 (OEB)
/ADCs/ADCCLK_0: R38.2, U2.C11 (IO_L11P_T1_SRCC_15)
/ADCs/ADCCLK_1: R62.2, U2.D13 (IO_L12P_T1_MRCC_15)
/ADCs/ADCCLK_2: R40.2, U2.E12 (IO_L13P_T2_MRCC_15)
/ADCs/ADCCLK_3: R64.2, U2.E3 (IO_L11P_T1_SRCC_35)
/ADCs/ADCCLK_4: R42.2, U2.D4 (IO_L12P_T1_MRCC_35)
/ADCs/ADCCLK_5: R63.2, U2.F5 (IO_L13P_T2_MRCC_35)
/ADCs/ADCCLK_6: R44.2, U2.N11 (IO_L13P_T2_MRCC_14)
/ADCs/ADCCLK_7: R65.2, U2.N13 (IO_L11P_T1_SRCC_14)
/ADCs/ADC_SCLK: U1.45 (SCLK/DFS), U2.N12 (IO_L13N_T2_MRCC_14), U3.45 (SCLK/DFS), U4.45 (SCLK/DFS), U5.45 (SCLK/DFS)
/ADCs/ADC_SDIO: U1.44 (SDIO/DCS), U2.M6 (IO_L19P_T3_A10_D26_14), U3.44 (SDIO/DCS), U4.44 (SDIO/DCS), U5.44 (SDIO/DCS)
/ADCs/ADC_SYNC: U2.B16 (IO_L10N_T1_AD11N_15), U6.3 (IOB_9b)
/ADCs/CLIP_0: U1.43 (ORA), U6.6 (IOB_13b)
/ADCs/CLIP_1: U1.22 (ORB), U6.9 (IOB_16a)
/ADCs/CLIP_2: U3.43 (ORA), U6.10 (IOB_18a)
/ADCs/CLIP_3: U4.22 (ORB), U6.11 (IOB_20a)
/ADCs/CLIP_4: U4.43 (ORA), U6.12 (IOB_22a)
/ADCs/CLIP_5: U3.22 (ORB), U6.21 (IOB_23b)
/ADCs/CLIP_6: U5.43 (ORA), U6.13 (IOB_24a)
/ADCs/CLIP_7: U5.22 (ORB), U6.20 (IOB_25b_G3)
/ADCs/CLK0_N: R54.2, U1.2 (CLK_N); also elsewhere on the board
/ADCs/CLK0_P: R54.1, U1.1 (CLK_P); also elsewhere on the board
/ADCs/CLK1_N: R55.2, U3.2 (CLK_N); also elsewhere on the board
/ADCs/CLK1_P: R55.1, U3.1 (CLK_P); also elsewhere on the board
/ADCs/CLK2_N: R56.2, U4.2 (CLK_N); also elsewhere on the board
/ADCs/CLK2_P: R56.1, U4.1 (CLK_P); also elsewhere on the board
/ADCs/CLK3_N: R57.2, U5.2 (CLK_N); also elsewhere on the board
/ADCs/CLK3_P: R57.1, U5.1 (CLK_P); also elsewhere on the board
/ADCs/D0_0: U1.27 (D0A), U2.D10 (IO_0_15)
/ADCs/D0_1: U1.29 (D1A), U2.C12 (IO_L11N_T1_SRCC_15)
/ADCs/D0_2: U1.30 (D2A), U2.C14 (IO_L8P_T1_AD10P_15)
/ADCs/D0_3: U1.31 (D3A), U2.C16 (IO_L10P_T1_AD11P_15)
/ADCs/D0_4: U1.32 (D4A), U2.D14 (IO_L15P_T2_DQS_15)
/ADCs/D0_5: U1.33 (D5A), U2.D11 (IO_L14N_T2_SRCC_15)
/ADCs/D0_6: U1.34 (D6A), U2.F12 (IO_L16P_T2_A28_15)
/ADCs/D0_7: U1.35 (D7A), U2.D15 (IO_L15N_T2_DQS_ADV_B_15)
/ADCs/D0_8: U1.36 (D8A), U2.F13 (IO_L16N_T2_A27_15)
/ADCs/D0_9: U1.38 (D9A), U2.E16 (IO_L17P_T2_A26_15)
/ADCs/D0_10: U1.39 (D10A), U2.A12 (IO_L5N_T0_AD9N_15)
/ADCs/D0_11: U1.40 (D11A), U2.B14 (IO_L8N_T1_AD10N_15)
/ADCs/D0_12: U1.41 (D12A), U2.A15 (IO_L9N_T1_DQS_AD3N_15)
/ADCs/D0_13: U1.42 (D13A), U2.A13 (IO_L7P_T1_AD2P_15)
/ADCs/D1_0: U1.6 (D0B), U2.E15 (IO_L18N_T2_A23_15)
/ADCs/D1_1: U1.7 (D1B), U2.H11 (IO_L19P_T3_A22_15)
/ADCs/D1_2: U1.8 (D2B), U2.G12 (IO_L19N_T3_A21_VREF_15)
/ADCs/D1_3: U1.9 (D3B), U2.H12 (IO_L20P_T3_A20_15)
/ADCs/D1_4: U1.11 (D4B), U2.H13 (IO_L20N_T3_A19_15)
/ADCs/D1_5: U1.12 (D5B), U2.G14 (IO_L21P_T3_DQS_15)
/ADCs/D1_6: U1.13 (D6B), U2.F14 (IO_L21N_T3_DQS_A18_15)
/ADCs/D1_7: U1.14 (D7B), U2.H16 (IO_L22P_T3_A17_15)
/ADCs/D1_8: U1.15 (D8B), U2.G16 (IO_L22N_T3_A16_15)
/ADCs/D1_9: U1.16 (D9B), U2.J15 (IO_L23P_T3_FOE_B_15)
/ADCs/D1_10: U1.17 (D10B), U2.J16 (IO_L23N_T3_FWE_B_15)
/ADCs/D1_11: U1.18 (D11B), U2.H14 (IO_L24P_T3_RS1_15)
/ADCs/D1_12: U1.20 (D12B), U2.G15 (IO_L24N_T3_RS0_15)
/ADCs/D1_13: U1.21 (D13B), U2.G11 (IO_25_15)
/ADCs/D2_0: U2.B7 (IO_L1P_T0_AD4P_35), U3.27 (D0A)
/ADCs/D2_1: U2.D5 (IO_L6N_T0_VREF_35), U3.29 (D1A)
/ADCs/D2_2: U2.B6 (IO_L2P_T0_AD12P_35), U3.30 (D2A)
/ADCs/D2_3: U2.C6 (IO_L5N_T0_AD13N_35), U3.31 (D3A)
/ADCs/D2_4: U2.D6 (IO_L6P_T0_35), U3.32 (D4A)
/ADCs/D2_5: U2.A8 (IO_L2P_T0_AD8P_15), U3.33 (D5A)
/ADCs/D2_6: U2.B9 (IO_L3P_T0_DQS_AD1P_15), U3.34 (D6A)
/ADCs/D2_7: U2.A9 (IO_L2N_T0_AD8N_15), U3.35 (D7A)
/ADCs/D2_8: U2.B10 (IO_L4P_T0_15), U3.36 (D8A)
/ADCs/D2_9: U2.A10 (IO_L3N_T0_DQS_AD1N_15), U3.38 (D9A)
/ADCs/D2_10: U2.B11 (IO_L4N_T0_15), U3.39 (D10A)
/ADCs/D2_11: U2.B12 (IO_L5P_T0_AD9P_15), U3.40 (D11A)
/ADCs/D2_12: U2.D16 (IO_L17N_T2_A25_15), U3.41 (D12A)
/ADCs/D2_13: U2.F15 (IO_L18P_T2_A24_15), U3.42 (D13A)
/ADCs/D3_0: U2.L2 (IO_L23N_T3_35), U4.6 (D0B)
/ADCs/D3_1: U2.K1 (IO_L22P_T3_35), U4.7 (D1B)
/ADCs/D3_2: U2.K2 (IO_L24N_T3_35), U4.8 (D2B)
/ADCs/D3_3: U2.J1 (IO_L22N_T3_35), U4.9 (D3B)
/ADCs/D3_4: U2.J3 (IO_L21P_T3_DQS_35), U4.11 (D4B)
/ADCs/D3_5: U2.H1 (IO_L20P_T3_35), U4.12 (D5B)
/ADCs/D3_6: U2.H2 (IO_L20P_T3_35), U4.13 (D6B)
/ADCs/D3_7: U2.G1 (IO_L17N_T2_35), U4.14 (D7B)
/ADCs/D3_8: U2.G2 (IO_L17P_T2_35), U4.15 (D8B)
/ADCs/D3_9: U2.F2 (IO_L15P_T2_DQS_35), U4.16 (D9B)
/ADCs/D3_10: U2.E1 (IO_L15N_T2_DQS_35), U4.17 (D10B)
/ADCs/D3_11: U2.E2 (IO_L10P_T1_AD15P_35), U4.18 (D11B)
/ADCs/D3_12: U2.D1 (IO_L10N_T1_AD15N_35), U4.20 (D12B)
/ADCs/D3_13: U2.C1 (IO_L9P_T1_DQS_AD7P_35), U4.21 (D13B)
/ADCs/D4_0: U2.C2 (IO_L7N_T1_AD6N_35), U4.27 (D0A)
/ADCs/D4_1: U2.B1 (IO_L9N_T1_DQS_AD7N_35), U4.29 (D1A)
/ADCs/D4_2: U2.A2 (IO_L8N_T1_AD14N_35), U4.30 (D2A)
/ADCs/D4_3: U2.B2 (IO_L8P_T1_AD14P_35), U4.31 (D3A)
/ADCs/D4_4: U2.A3 (IO_L4N_T0_35), U4.32 (D4A)
/ADCs/D4_5: U2.A4 (IO_L3N_T0_DQS_AD5N_35), U4.33 (D5A)
/ADCs/D4_6: U2.B4 (IO_L4P_T0_35), U4.34 (D6A)
/ADCs/D4_7: U2.A5 (IO_L3P_T0_DQS_AD5P_35), U4.35 (D7A)
/ADCs/D4_8: U2.B5 (IO_L2N_T0_AD12N_35), U4.36 (D8A)
/ADCs/D4_9: U2.A7 (IO_L1N_T0_AD4N_35), U4.38 (D9A)
/ADCs/D4_10: U2.H3 (IO_L21P_T3_DQS_35), U4.39 (D10A)
/ADCs/D4_11: U2.J5 (IO_L19P_T3_35), U4.40 (D11A)
/ADCs/D4_12: U2.J4 (IO_L19N_T3_VREF_35), U4.41 (D12A)
/ADCs/D4_13: U2.K3 (IO_L24P_T3_35), U4.42 (D13A)
/ADCs/D5_0: U2.C9 (IO_L1N_T0_AD0N_15), U3.6 (D0B)
/ADCs/D5_1: U2.D8 (IO_L6P_T0_15), U3.7 (D1B)
/ADCs/D5_2: U2.C8 (IO_L1P_T0_AD0P_15), U3.8 (D2B)
/ADCs/D5_3: U2.D9 (IO_L6N_T0_VREF_15), U3.9 (D3B)
/ADCs/D5_4: U2.C7 (IO_L5P_T0_AD13P_35), U3.11 (D4B)
/ADCs/D5_5: U2.E6 (IO_0_35), U3.12 (D5B)
/ADCs/D5_6: U2.E5 (IO_L13N_T2_MRCC_35), U3.13 (D6B)
/ADCs/D5_7: U2.F4 (IO_L14P_T2_SRCC_35), U3.14 (D7B)
/ADCs/D5_8: U2.F3 (IO_L14N_T2_SRCC_35), U3.15 (D8B)
/ADCs/D5_9: U2.M12 (IO_L6N_T0_D08_VREF_14), U3.16 (D9B)
/ADCs/D5_10: U2.G5 (IO_L16P_T2_35), U3.17 (D10B)
/ADCs/D5_11: U2.D3 (IO_L11N_T1_SRCC_35), U3.18 (D11B)
/ADCs/D5_12: U2.C3 (IO_L7P_T1_AD6P_35), U3.20 (D12B)
/ADCs/D5_13: U2.C4 (IO_L12N_T1_MRCC_35), U3.21 (D13B)
/ADCs/D6_0: U2.R8 (IO_L20N_T3_A07_D23_14), U5.27 (D0A)
/ADCs/D6_1: U2.T8 (IO_L21N_T3_DQS_A06_D22_14), U5.29 (D1A)
/ADCs/D6_2: U2.P8 (IO_L20P_T3_A08_D24_14), U5.30 (D2A)
/ADCs/D6_3: U2.T7 (IO_L21P_T3_DQS_14), U5.31 (D3A)
/ADCs/D6_4: U2.R7 (IO_L24N_T3_A00_D16_14), U5.32 (D4A)
/ADCs/D6_5: U2.R6 (IO_L24P_T3_A01_D17_14), U5.33 (D5A)
/ADCs/D6_6: U2.T5 (IO_L23N_T3_A02_D18_14), U5.34 (D6A)
/ADCs/D6_7: U2.R5 (IO_L23P_T3_A03_D19_14), U5.35 (D7A)
/ADCs/D6_8: U2.P13 (IO_L11N_T1_SRCC_14), U5.36 (D8A)
/ADCs/D6_9: U2.P10 (IO_L14P_T2_SRCC_14), U5.38 (D9A)
/ADCs/D6_10: U2.P11 (IO_L14N_T2_SRCC_14), U5.39 (D10A)
/ADCs/D6_11: U2.P9 (IO_L18N_T2_A11_D27_14), U5.40 (D11A)
/ADCs/D6_12: U2.M14 (IO_L4N_T0_D05_14), U5.41 (D12A)
/ADCs/D6_13: U2.N9 (IO_L18P_T2_A12_D28_14), U5.42 (D13A)
/ADCs/D7_0: U2.P16 (IO_L8N_T1_D12_14), U5.6 (D0B)
/ADCs/D7_1: U2.P15 (IO_L8P_T1_D11_14), U5.7 (D1B)
/ADCs/D7_2: U2.R16 (IO_L9N_T1_DQS_D13_14), U5.8 (D2B)
/ADCs/D7_3: U2.R15 (IO_L9P_T1_DQS_14), U5.9 (D3B)
/ADCs/D7_4: U2.T15 (IO_L10N_T1_D15_14), U5.11 (D4B)
/ADCs/D7_5: U2.T14 (IO_L10P_T1_D14_14), U5.12 (D5B)
/ADCs/D7_6: U2.R13 (IO_L16P_T2_CSI_B_14), U5.13 (D6B)
/ADCs/D7_7: U2.T13 (IO_L16N_T2_A15_D31_14), U5.14 (D7B)
/ADCs/D7_8: U2.R12 (IO_L15P_T2_DQS_RDWR_B_14), U5.15 (D8B)
/ADCs/D7_9: U2.T12 (IO_L15N_T2_DQS_DOUT_CSO_B_14), U5.16 (D9B)
/ADCs/D7_10: U2.R11 (IO_L17N_T2_A13_D29_14), U5.17 (D10B)
/ADCs/D7_11: U2.R10 (IO_L17P_T2_A14_D30_14), U5.18 (D11B)
/ADCs/D7_12: U2.T10 (IO_L22N_T3_A04_D20_14), U5.20 (D12B)
/ADCs/D7_13: U2.T9 (IO_L22P_T3_A05_D21_14), U5.21 (D13B)
/ADCs/FLASH_DQ0: U2.J13 (IO_L1P_T0_D00_MOSI_14); also elsewhere on the board
/ADCs/FLASH_DQ1: U2.J14 (IO_L1N_T0_D01_DIN_14); also elsewhere on the board
/ADCs/FLASH_DQ2: U2.K15 (IO_L2P_T0_D02_14); also elsewhere on the board
/ADCs/FLASH_DQ3: U2.K16 (IO_L2N_T0_D03_14); also elsewhere on the board
/ADCs/FTDI_SI_WU_N: U6.46 (IOB_0a); also elsewhere on the board
/ADCs/ICE40_DONE: TP9.3, U2.L14 (IO_L4P_T0_D04_14), U6.7 (CDONE)
/ADCs/ICE40_RST_N: R11.1, TP9.2, U2.M15 (IO_L3N_T0_DQS_EMCCLK_14), U6.8 (CRESET_B)
/ADCs/ICE40_SPI_CS_N: R12.1, TP9.7, U2.E13 (IO_L13N_T2_MRCC_15), U6.16 (IOB_35b_SPI_SS)
/ADCs/ICE40_SPI_DQ2: TP9.9, U2.N16 (IO_L7N_T1_D10_14), U6.18 (IOB_31b)
/ADCs/ICE40_SPI_DQ3: TP9.8, U2.M16 (IO_L7P_T1_D09_14), U6.19 (IOB_29b)
/ADCs/ICE40_SPI_SCK: TP9.6, U2.L13 (IO_L5N_T0_D07_14), U6.15 (IOB_34a_SPI_SCK)
/ADCs/ICE40_SPI_SI: TP9.5, U2.K13 (IO_L5P_T0_D06_14), U6.17 (IOB_33b_SPI_SI)
/ADCs/ICE40_SPI_SO: TP9.4, U2.E11 (IO_L14P_T2_SRCC_15), U6.14 (IOB_32a_SPI_SO)
/ADCs/IN0_N: R46.2, U1.52 (VIN-A); also elsewhere on the board
/ADCs/IN0_P: R46.1, U1.51 (VIN+A); also elsewhere on the board
/ADCs/IN1_N: R47.2, U1.61 (VIN-B); also elsewhere on the board
/ADCs/IN1_P: R47.1, U1.62 (VIN+B); also elsewhere on the board
/ADCs/IN2_N: R48.2, U3.52 (VIN-A); also elsewhere on the board
/ADCs/IN2_P: R48.1, U3.51 (VIN+A); also elsewhere on the board
/ADCs/IN3_N: R49.2, U4.61 (VIN-B); also elsewhere on the board
/ADCs/IN3_P: R49.1, U4.62 (VIN+B); also elsewhere on the board
/ADCs/IN4_N: R50.2, U4.52 (VIN-A); also elsewhere on the board
/ADCs/IN4_P: R50.1, U4.51 (VIN+A); also elsewhere on the board
/ADCs/IN5_N: R51.2, U3.61 (VIN-B); also elsewhere on the board
/ADCs/IN5_P: R51.1, U3.62 (VIN+B); also elsewhere on the board
/ADCs/IN6_N: R52.2, U5.52 (VIN-A); also elsewhere on the board
/ADCs/IN6_P: R52.1, U5.51 (VIN+A); also elsewhere on the board
/ADCs/IN7_N: R53.2, U5.61 (VIN-B); also elsewhere on the board
/ADCs/IN7_P: R53.1, U5.62 (VIN+B); also elsewhere on the board
/ADCs/PLL_UWIRE_CLK: U2.K5 (IO_25_35); also elsewhere on the board
/ADCs/PLL_UWIRE_DATA: U2.L3 (IO_L23P_T3_35); also elsewhere on the board
/ADCs/PLL_UWIRE_LE: U2.H5 (IO_L18P_T2_35); also elsewhere on the board
/ADCs/SYNC_0: U1.3 (SYNC), U6.48 (IOB_4a)
/ADCs/SYNC_1: U3.3 (SYNC), U6.45 (IOB_5b)
/ADCs/SYNC_2: U4.3 (SYNC), U6.2 (IOB_6a)
/ADCs/SYNC_3: U5.3 (SYNC), U6.4 (IOB_8a)
/ADCs/SYS_CLK_N: R8.2, R83.2, R84.2, U2.P14 (IO_L12N_T1_MRCC_14); also elsewhere on the board
/ADCs/SYS_CLK_P: R8.1, R81.2, R82.2, U2.N14 (IO_L12P_T1_MRCC_14); also elsewhere on the board
/ADCs/VCM0: C189.1, U1.57 (VCM)
/ADCs/VCM1: C190.1, U3.57 (VCM)
/ADCs/VCM2: C191.1, U4.57 (VCM)
/ADCs/VCM3: C192.1, U5.57 (VCM)
/CLK_4: U6.44 (IOB_3b_G6); also elsewhere on the board
/D1V8: C108.1, C109.1, C110.1, C111.1, C112.1, C113.1, C114.1, C115.1, C116.1, C117.1, C118.1, C119.1, C120.1, C121.1, C122.1, C123.1, C124.1, C125.1, C126.1, C127.1, R81.1, R83.1, U1.10 (DRVDD), U1.19 (DRVDD), U1.28 (DRVDD), U1.37 (DRVDD), U2.L15 (IO_L3P_T0_DQS_PUDC_B_14), U3.10 (DRVDD), U3.19 (DRVDD), U3.28 (DRVDD), U3.37 (DRVDD), U4.10 (DRVDD), U4.19 (DRVDD), U4.28 (DRVDD), U4.37 (DRVDD), U5.10 (DRVDD), U5.19 (DRVDD), U5.28 (DRVDD), U5.37 (DRVDD); also elsewhere on the board
/GND: C108.2, C109.2, C110.2, C111.2, C112.2, C113.2, C114.2, C115.2, C116.2, C117.2, C118.2, C119.2, C120.2, C121.2, C122.2, C123.2, C124.2, C125.2, C126.2, C127.2, C128.2, C129.2, C130.2, C131.2, C132.2, C133.1, C134.2, C135.1, C136.2, C137.1, C138.2, C139.1, C140.2, C141.1, C142.2, C143.1, C144.2, C145.1, C146.2, C147.1, C148.2, C149.1, C150.2, C151.1, C152.2, C153.1, C154.2, C155.1, C156.2, C157.1, C158.2, C159.1, C160.2, C161.1, C162.2, C163.1, C189.2, C190.2, C191.2, C192.2, C202.2, C203.2, C204.2, C205.2, C206.2, C207.2, C208.2, C209.2, R11.2, R39.2, R41.2, R43.2, R45.2, R82.1, R84.1, TP9.1, TP9.10, U1.PAD (GND), U3.PAD (GND), U4.PAD (GND), U5.PAD (GND); also elsewhere on the board
/MCU/ADC0_PDWN: U1.48 (PDWN); also elsewhere on the board
/MCU/ADC1_PDWN: U3.48 (PDWN); also elsewhere on the board
/MCU/ADC2_PDWN: U4.48 (PDWN); also elsewhere on the board
/MCU/ADC3_PDWN: U5.48 (PDWN); also elsewhere on the board
/QSPI flash/FLASH_CS_N: R1.1; also elsewhere on the board
/VREF: C202.1, C203.1, C204.1, C205.1, C206.1, C207.1, C208.1, C209.1, U1.55 (VREF), U3.55 (VREF), U4.55 (VREF), U5.55 (VREF); also elsewhere on the board
unnamed: R1.2, U2.L12 (IO_L6P_T0_FCS_B_14)
unnamed: R38.1, U1.24 (DCOA)
unnamed: R39.1, U1.58 (RBIAS)
unnamed: R40.1, U3.24 (DCOA)
unnamed: R41.1, U3.58 (RBIAS)
unnamed: R42.1, U4.24 (DCOA)
unnamed: R43.1, U4.58 (RBIAS)
unnamed: R44.1, U5.24 (DCOA)
unnamed: R45.1, U5.58 (RBIAS)
unnamed: R62.1, U1.23 (DCOB)
unnamed: R63.1, U3.23 (DCOB)
unnamed: R64.1, U4.23 (DCOB)
unnamed: R65.1, U5.23 (DCOB)

Notes on the sheet:
Bank 35 LVCMOS18
U5 analog
Bank 15 LVCMOS18
LVDS biasing
Bank 2 LVCMOS18
Bank 14 LVCMOS18
U4 analog
U4 digital
Analog input terminations
Clock input terminations
Bank 1 LVCMOS18
Place termination close to FPGA balls
VCM bias
U3 analog
Reference input is 7.5K ohm per ADC 4 in parallel is 1.875K equivalent At 1V that's 533 uA load
LA test point for Artix to ice40 bus 1.8V logic levels
U1 digital
U3 digital
U5 digital
U1 analog

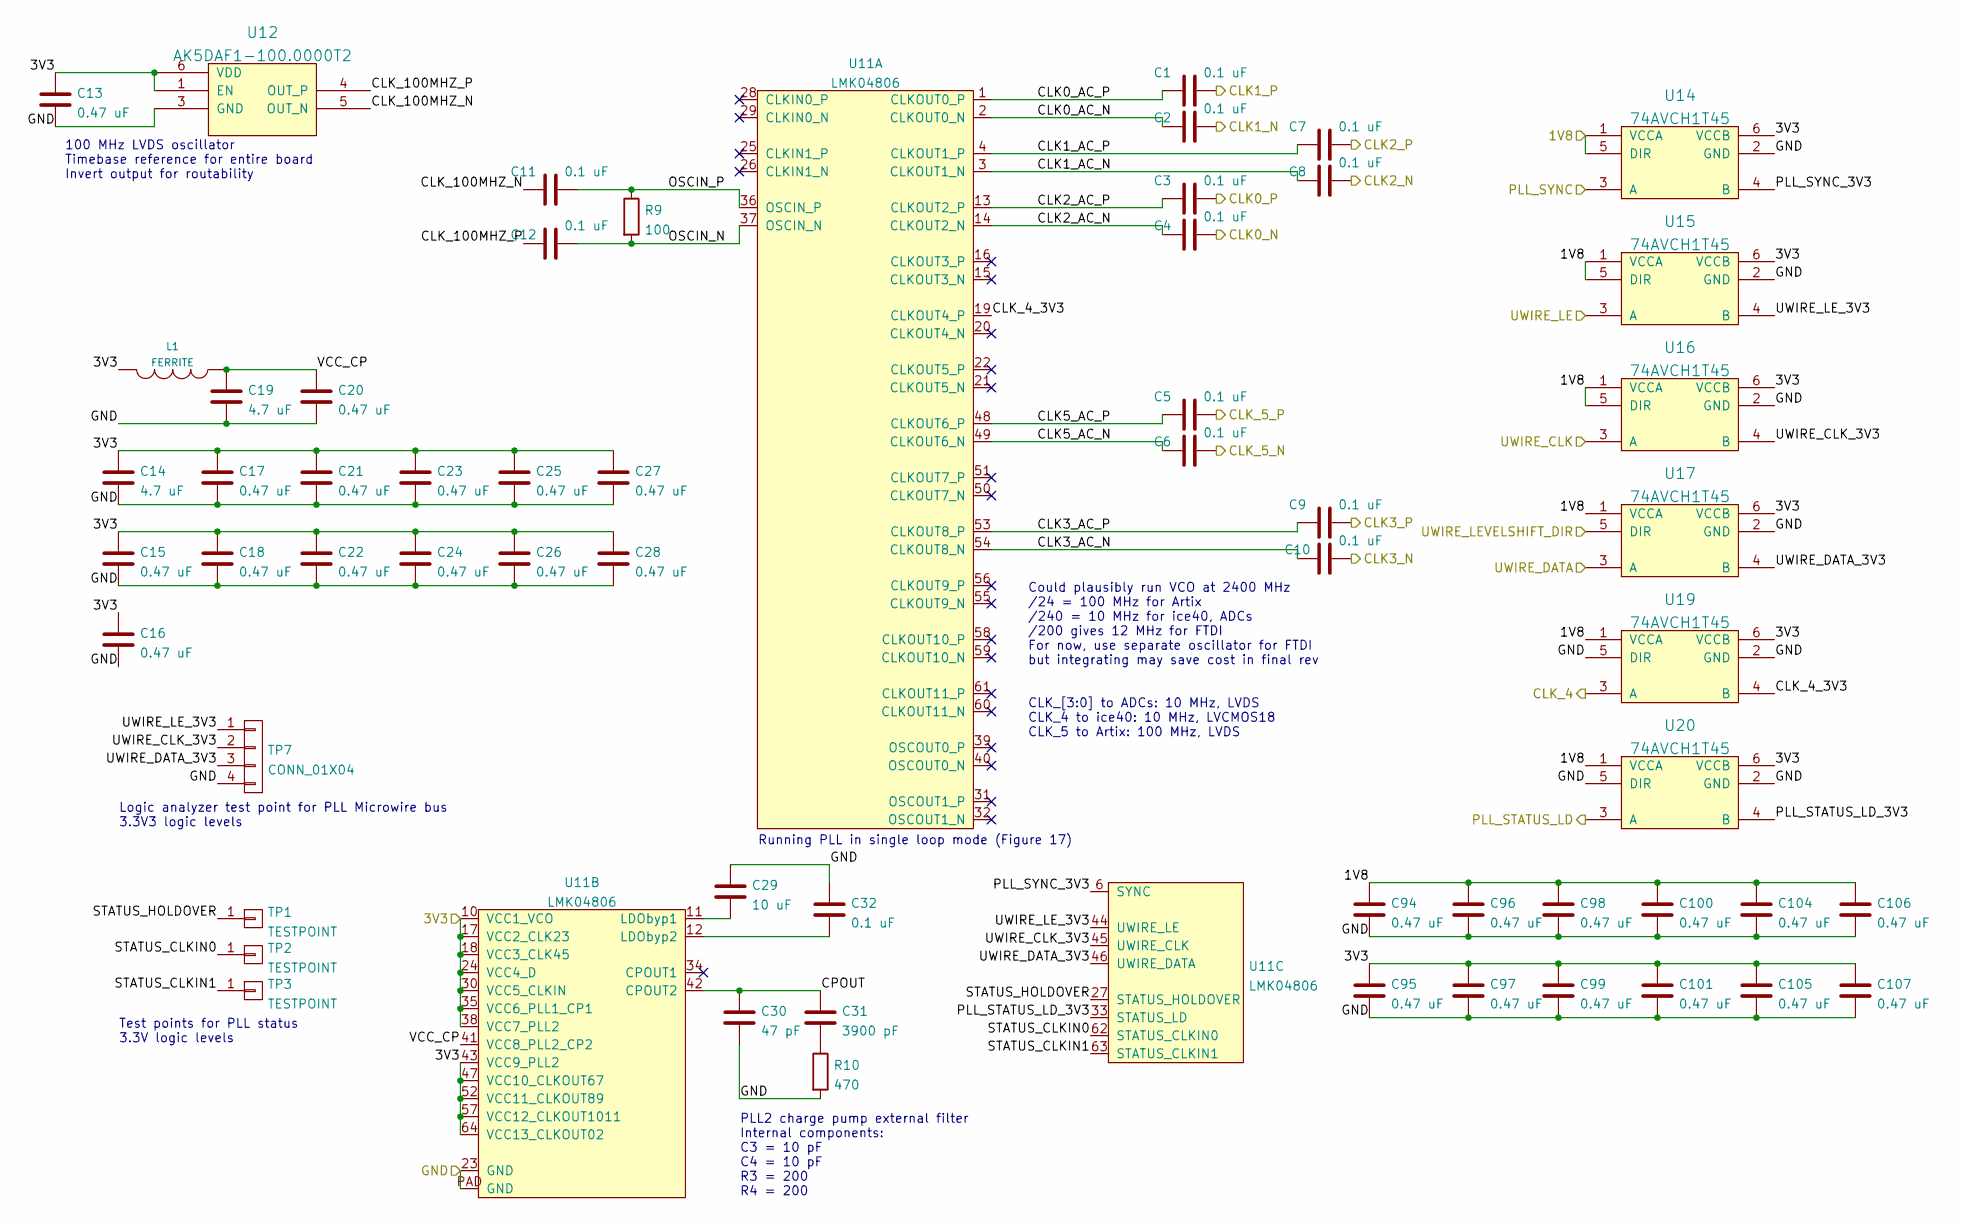
[picture p6: schematic clocking.kicad_sch, Digitizer board]

Parts:
C1, C2, C3, C4, C5, C6, C7, C8, C9, C10, C11, C12, C32: 0.1 uF; EIA_0402_CAP_NOSILK
C13, C15, C16, C17, C18, C20, C21, C22, C23, C24, C25, C26, C27, C28, C94, C95, C96, C97, C98, C99, C100, C101, C104, C105, C106, C107: 0.47 uF; EIA_0402_CAP_NOSILK
C14, C19: 4.7 uF; EIA_0603_CAP_NOSILK
C29: 10 uF; EIA_0805_CAP_NOSILK
C30: 47 pF; EIA_0402_CAP_NOSILK
C31: 3900 pF; EIA_0402_CAP_NOSILK
L1: FERRITE; EIA_0603_INDUCTOR_NOSILK
R9: 100; EIA_0402_RES_NOSILK
R10: 470; EIA_0402_RES_NOSILK
TP1, TP2, TP3: TESTPOINT; TESTPOINT_SMT_0.5MM
TP7: CONN_01X04; CONN_HEADER_2.54MM_1x4
U11: LMK04806; QFN_64_0.5MM_9x9MM
U12: AK5DAF1-100.0000T2; OSCILLATOR_LVDS_5.0x3.2
U14, U15, U16, U17, U19, U20: 74AVCH1T45; DFN_6_0.5MM_1.45x1.00MM

Connections:
/3V3: C13.1, C14.1, C15.1, C16.1, C17.1, C18.1, C21.1, C22.1, C23.1, C24.1, C25.1, C26.1, C27.1, C28.1, C95.1, C97.1, C99.1, C101.1, C105.1, C107.1, L1.2, U11.10 (VCC1_VCO), U11.17 (VCC2_CLK23), U11.18 (VCC3_CLK45), U11.24 (VCC4_D), U11.30 (VCC5_CLKIN), U11.35 (VCC6_PLL1_CP1), U11.38 (VCC7_PLL2), U11.43 (VCC9_PLL2), U11.47 (VCC10_CLKOUT67), U11.52 (VCC11_CLKOUT89), U11.57 (VCC12_CLKOUT1011), U11.64 (VCC13_CLKOUT02), U12.1 (EN), U12.6 (VDD), U14.6 (VCCB), U15.6 (VCCB), U16.6 (VCCB), U17.6 (VCCB), U19.6 (VCCB), U20.6 (VCCB); also elsewhere on the board
/ADCs/CLK0_N: C4.2; also elsewhere on the board
/ADCs/CLK0_P: C3.2; also elsewhere on the board
/ADCs/CLK1_N: C2.2; also elsewhere on the board
/ADCs/CLK1_P: C1.2; also elsewhere on the board
/ADCs/CLK2_N: C8.2; also elsewhere on the board
/ADCs/CLK2_P: C7.2; also elsewhere on the board
/ADCs/CLK3_N: C10.2; also elsewhere on the board
/ADCs/CLK3_P: C9.2; also elsewhere on the board
/ADCs/PLL_UWIRE_CLK: U16.3 (A); also elsewhere on the board
/ADCs/PLL_UWIRE_DATA: U17.3 (A); also elsewhere on the board
/ADCs/PLL_UWIRE_LE: U15.3 (A); also elsewhere on the board
/ADCs/SYS_CLK_N: C6.2; also elsewhere on the board
/ADCs/SYS_CLK_P: C5.2; also elsewhere on the board
/CLK_4: U19.3 (A); also elsewhere on the board
/Clocking/CLK0_AC_N: C2.1, U11.2 (CLKOUT0_N)
/Clocking/CLK0_AC_P: C1.1, U11.1 (CLKOUT0_P)
/Clocking/CLK1_AC_N: C8.1, U11.3 (CLKOUT1_N)
/Clocking/CLK1_AC_P: C7.1, U11.4 (CLKOUT1_P)
/Clocking/CLK2_AC_N: C4.1, U11.14 (CLKOUT2_N)
/Clocking/CLK2_AC_P: C3.1, U11.13 (CLKOUT2_P)
/Clocking/CLK3_AC_N: C10.1, U11.54 (CLKOUT8_N)
/Clocking/CLK3_AC_P: C9.1, U11.53 (CLKOUT8_P)
/Clocking/CLK5_AC_N: C6.1, U11.49 (CLKOUT6_N)
/Clocking/CLK5_AC_P: C5.1, U11.48 (CLKOUT6_P)
/Clocking/CLK_4_3V3: U11.19 (CLKOUT4_P), U19.4 (B)
/Clocking/CLK_100MHZ_N: C11.1, U12.5 (OUT_N)
/Clocking/CLK_100MHZ_P: C12.1, U12.4 (OUT_P)
/Clocking/CPOUT: C30.1, C31.1, U11.42 (CPOUT2)
/Clocking/OSCIN_N: C12.2, R9.2, U11.37 (OSCIN_N)
/Clocking/OSCIN_P: C11.2, R9.1, U11.36 (OSCIN_P)
/Clocking/PLL_STATUS_LD_3V3: U11.33 (STATUS_LD), U20.4 (B)
/Clocking/PLL_SYNC_3V3: U11.6 (SYNC), U14.4 (B)
/Clocking/STATUS_CLKIN0: TP2.1, U11.62 (STATUS_CLKIN0)
/Clocking/STATUS_CLKIN1: TP3.1, U11.63 (STATUS_CLKIN1)
/Clocking/STATUS_HOLDOVER: TP1.1, U11.27 (STATUS_HOLDOVER)
/Clocking/UWIRE_CLK_3V3: TP7.2, U11.45 (UWIRE_CLK), U16.4 (B)
/Clocking/UWIRE_DATA_3V3: TP7.3, U11.46 (UWIRE_DATA), U17.4 (B)
/Clocking/UWIRE_LE_3V3: TP7.1, U11.44 (UWIRE_LE), U15.4 (B)
/Clocking/VCC_CP: C19.1, C20.1, L1.1, U11.41 (VCC8_PLL2_CP2)
/D1V8: C94.1, C96.1, C98.1, C100.1, C104.1, C106.1, U14.1 (VCCA), U14.5 (DIR), U15.1 (VCCA), U15.5 (DIR), U16.1 (VCCA), U16.5 (DIR), U17.1 (VCCA), U19.1 (VCCA), U20.1 (VCCA); also elsewhere on the board
/GND: C13.2, C14.2, C15.2, C16.2, C17.2, C18.2, C19.2, C20.2, C21.2, C22.2, C23.2, C24.2, C25.2, C26.2, C27.2, C28.2, C29.1, C30.2, C32.1, C94.2, C95.2, C96.2, C97.2, C98.2, C99.2, C100.2, C101.2, C104.2, C105.2, C106.2, C107.2, R10.2, TP7.4, U11.23 (GND), U11.PAD (GND), U12.3 (GND), U14.2 (GND), U15.2 (GND), U16.2 (GND), U17.2 (GND), U19.2 (GND), U19.5 (DIR), U20.2 (GND), U20.5 (DIR); also elsewhere on the board
/PLL_STATUS_LD: U20.3 (A); also elsewhere on the board
/PLL_SYNC: U14.3 (A); also elsewhere on the board
/UWIRE_LEVELSHIFT_DIR: U17.5 (DIR); also elsewhere on the board
unnamed: C29.2, U11.11 (LDObyp1)
unnamed: C31.2, R10.1
unnamed: C32.2, U11.12 (LDObyp2)

Notes on the sheet:
100 MHz LVDS oscillator Timebase reference for entire board Invert output for routability
Test points for PLL status 3.3V logic levels
CLK_[3:0] to ADCs: 10 MHz, LVDS CLK_4 to ice40: 10 MHz, LVCMOS18 CLK_5 to Artix: 100 MHz, LVDS
Running PLL in single loop mode (Figure 17)
Could plausibly run VCO at 2400 MHz /24 = 100 MHz for Artix /240 = 10 MHz for ice40, ADCs /200 gives 12 MHz for FTDI For now, use separate oscillator for FTDI but integrating may save cost in final rev
Logic analyzer test point for PLL Microwire bus 3.3V3 logic levels
PLL2 charge pump external filter Internal components: C3 = 10 pF C4 = 10 pF R3 = 200 R4 = 200

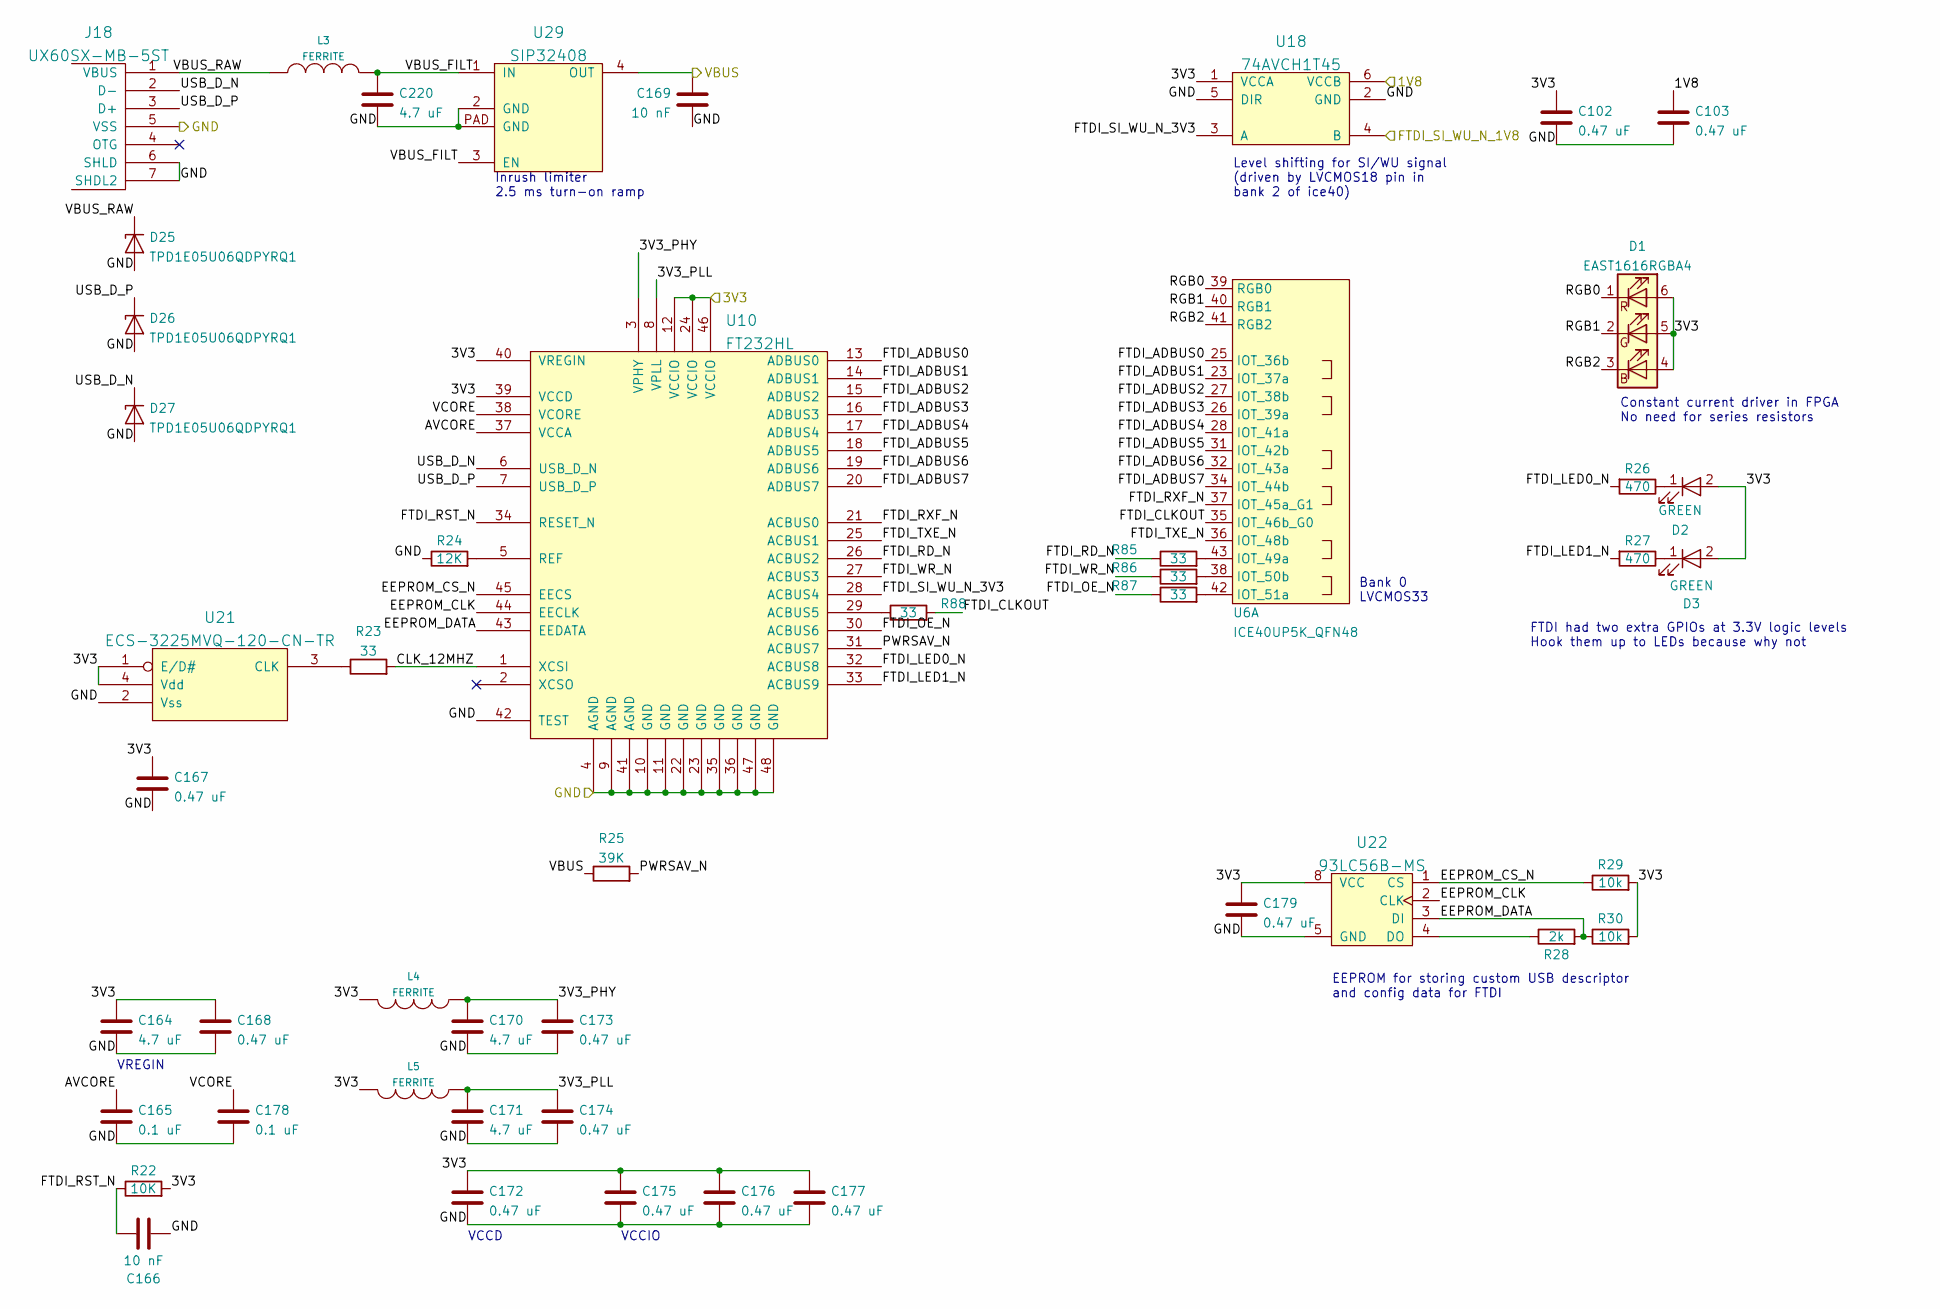
[picture p7: schematic ftdi.kicad_sch, Digitizer board]

Parts:
C102, C103, C167, C168, C172, C173, C174, C175, C176, C177, C179: 0.47 uF; EIA_0402_CAP_NOSILK
C164, C170, C171, C220: 4.7 uF; EIA_0603_CAP_NOSILK
C165, C178: 0.1 uF; EIA_0402_CAP_NOSILK
C166, C169: 10 nF; EIA_0603_CAP_NOSILK
D1: EAST1616RGBA4; LED_EVERLIGHT_EAST1616RGBA4
D2, D3: GREEN; EIA_0603_LED
D25, D26, D27: TPD1E05U06QDPYRQ1; DFN_2_1x0.6_TI_DPY
J18: UX60SX-MB-5ST; CONN_HIROSE_UX60S-MB-5ST_MINI_USB
L3, L4, L5: FERRITE; EIA_0603_INDUCTOR_NOSILK
R22: 10K; EIA_0402_RES_NOSILK
R23, R85, R86, R87, R88: 33; EIA_0402_RES_NOSILK
R24: 12K; EIA_0402_RES_NOSILK
R25: 39K; EIA_0402_RES_NOSILK
R26, R27: 470; EIA_0402_RES_NOSILK
R28: 2k; EIA_0402_RES_NOSILK
R29, R30: 10k; EIA_0402_RES_NOSILK
U6: ICE40UP5K_QFN48; QFN_48_0.5MM_7x7MM
U10: FT232HL; QFP_48_0.5MM
U18: 74AVCH1T45; DFN_6_0.5MM_1.45x1.00MM
U21: ECS-3225MVQ-120-CN-TR; OSCILLATOR_3.2x2.5
U22: 93LC56B-MS; SOP_8_0.5MM_3MM
U29: SIP32408; DFN_4_0.5MM_1.6x1.2MM

Connections:
/3V3: C102.1, C164.1, C167.1, C168.1, C172.1, C175.1, C176.1, C177.1, C179.1, D1.4 (BA), D1.5 (GA), D1.6 (RA), D2.2 (A), D3.2 (A), L4.2, L5.2, R22.2, R29.2, R30.2, U10.12 (VCCIO), U10.24 (VCCIO), U10.39 (VCCD), U10.40 (VREGIN), U10.46 (VCCIO), U18.1 (VCCA), U21.1 (E/D#), U21.4 (Vdd), U22.8 (VCC); also elsewhere on the board
/ADCs/FTDI_SI_WU_N: U18.4 (B); also elsewhere on the board
/D1V8: C103.1, U18.6 (VCCB); also elsewhere on the board
/FTDI USB interface/3V3_PHY: C170.1, C173.1, L4.1, U10.3 (VPHY)
/FTDI USB interface/3V3_PLL: C171.1, C174.1, L5.1, U10.8 (VPLL)
/FTDI USB interface/AVCORE: C165.1, U10.37 (VCCA)
/FTDI USB interface/CLK_12MHZ: R23.2, U10.1 (XCSI)
/FTDI USB interface/EEPROM_CLK: U10.44 (EECLK), U22.2 (CLK)
/FTDI USB interface/EEPROM_CS_N: R29.1, U10.45 (EECS), U22.1 (CS)
/FTDI USB interface/EEPROM_DATA: R28.2, R30.1, U10.43 (EEDATA), U22.3 (DI)
/FTDI USB interface/FTDI_ADBUS0: U6.25 (IOT_36b), U10.13 (ADBUS0)
/FTDI USB interface/FTDI_ADBUS1: U6.23 (IOT_37a), U10.14 (ADBUS1)
/FTDI USB interface/FTDI_ADBUS2: U6.27 (IOT_38b), U10.15 (ADBUS2)
/FTDI USB interface/FTDI_ADBUS3: U6.26 (IOT_39a), U10.16 (ADBUS3)
/FTDI USB interface/FTDI_ADBUS4: U6.28 (IOT_41a), U10.17 (ADBUS4)
/FTDI USB interface/FTDI_ADBUS5: U6.31 (IOT_42b), U10.18 (ADBUS5)
/FTDI USB interface/FTDI_ADBUS6: U6.32 (IOT_43a), U10.19 (ADBUS6)
/FTDI USB interface/FTDI_ADBUS7: U6.34 (IOT_44b), U10.20 (ADBUS7)
/FTDI USB interface/FTDI_CLKOUT: R88.2, U6.35 (IOT_46b_G0)
/FTDI USB interface/FTDI_LED0_N: R26.2, U10.32 (ACBUS8)
/FTDI USB interface/FTDI_LED1_N: R27.2, U10.33 (ACBUS9)
/FTDI USB interface/FTDI_OE_N: R87.1, U10.30 (ACBUS6)
/FTDI USB interface/FTDI_RD_N: R85.1, U10.26 (ACBUS2)
/FTDI USB interface/FTDI_RST_N: C166.1, R22.1, U10.34 (RESET_N)
/FTDI USB interface/FTDI_RXF_N: U6.37 (IOT_45a_G1), U10.21 (ACBUS0)
/FTDI USB interface/FTDI_SI_WU_N_3V3: U10.28 (ACBUS4), U18.3 (A)
/FTDI USB interface/FTDI_TXE_N: U6.36 (IOT_48b), U10.25 (ACBUS1)
/FTDI USB interface/FTDI_WR_N: R86.1, U10.27 (ACBUS3)
/FTDI USB interface/PWRSAV_N: R25.2, U10.31 (ACBUS7)
/FTDI USB interface/RGB0: D1.1 (RK), U6.39 (RGB0)
/FTDI USB interface/RGB1: D1.2 (GK), U6.40 (RGB1)
/FTDI USB interface/RGB2: D1.3 (BK), U6.41 (RGB2)
/FTDI USB interface/USB_D_N: D27.1 (K), J18.2 (D-), U10.6 (USB_D_N)
/FTDI USB interface/USB_D_P: D26.1 (K), J18.3 (D+), U10.7 (USB_D_P)
/FTDI USB interface/VBUS_FILT: C220.1, L3.1, U29.1 (IN), U29.3 (EN)
/FTDI USB interface/VBUS_RAW: D25.1 (K), J18.1 (VBUS), L3.2
/FTDI USB interface/VCORE: C178.1, U10.38 (VCORE)
/GND: C102.2, C103.2, C164.2, C165.2, C166.2, C167.2, C168.2, C169.2, C170.2, C171.2, C172.2, C173.2, C174.2, C175.2, C176.2, C177.2, C178.2, C179.2, C220.2, D25.2 (A), D26.2 (A), D27.2 (A), J18.5 (VSS), J18.6 (SHLD), J18.7 (SHDL2), R24.1, U10.4 (AGND), U10.9 (AGND), U10.10 (GND), U10.11 (GND), U10.22 (GND), U10.23 (GND), U10.35 (GND), U10.36 (GND), U10.41 (AGND), U10.42 (TEST), U10.47 (GND), U10.48 (GND), U18.2 (GND), U18.5 (DIR), U21.2 (Vss), U22.5 (GND), U29.2 (GND), U29.PAD (GND); also elsewhere on the board
/VBUS: C169.1, R25.1, U29.4 (OUT); also elsewhere on the board
unnamed: D2.1 (K), R26.1
unnamed: D3.1 (K), R27.1
unnamed: R23.1, U21.3 (CLK)
unnamed: R24.2, U10.5 (REF)
unnamed: R28.1, U22.4 (DO)
unnamed: R85.2, U6.43 (IOT_49a)
unnamed: R86.2, U6.38 (IOT_50b)
unnamed: R87.2, U6.42 (IOT_51a)
unnamed: R88.1, U10.29 (ACBUS5)

Notes on the sheet:
EEPROM for storing custom USB descriptor and config data for FTDI
VREGIN
Inrush limiter 2.5 ms turn-on ramp
FTDI had two extra GPIOs at 3.3V logic levels Hook them up to LEDs because why not
Level shifting for SI/WU signal (driven by LVCMOS18 pin in bank 2 of ice40)
VCCIO
Bank 0 LVCMOS33
VCCD
Constant current driver in FPGA No need for series resistors
