ammolytics/ballistic-daq/acquisition/board/acquisition.kicad_pcb

## KiCad design acquisition/board/acquisition.kicad_pcb (continued)

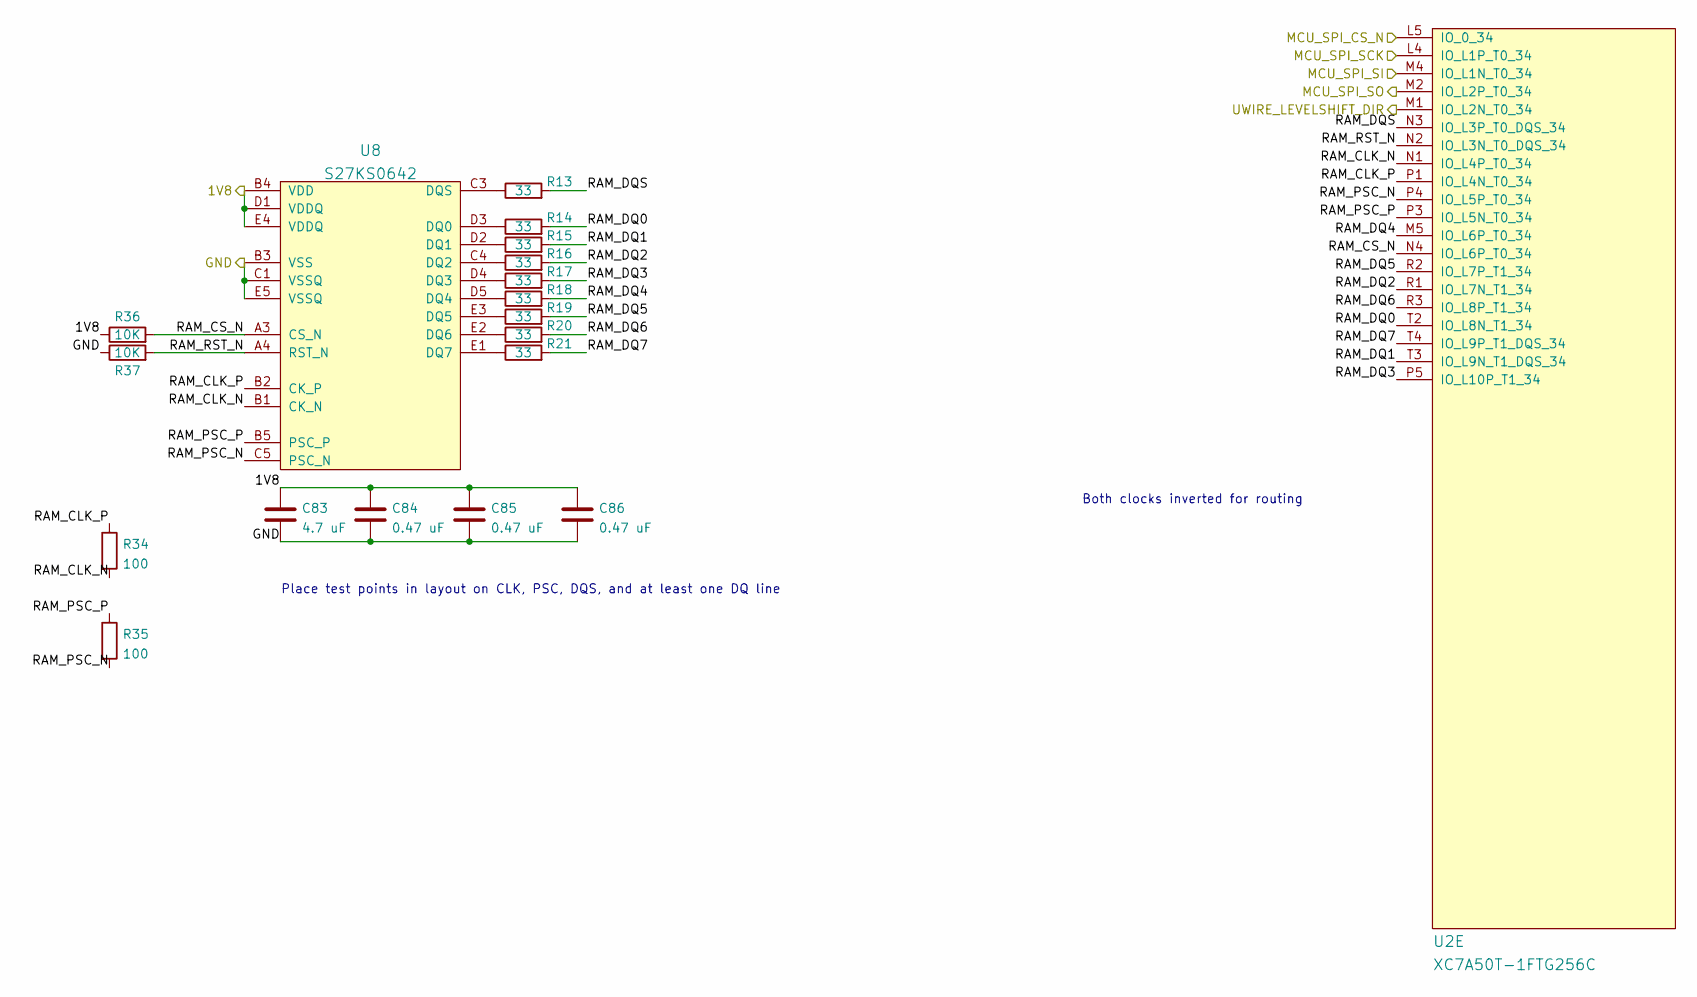
[picture p8: schematic ram.kicad_sch, Digitizer board]

Parts:
C83: 4.7 uF; EIA_0603_CAP_NOSILK
C84, C85, C86: 0.47 uF; EIA_0402_CAP_NOSILK
R13, R14, R15, R16, R17, R18, R19, R20, R21: 33; EIA_0402_RES_NOSILK
R34, R35: 100; EIA_0402_RES_NOSILK
R36, R37: 10K; EIA_0402_RES_NOSILK
U2: XC7A50T-1FTG256C; BGA_256_17x17_FULLARRAY_1MM_0.4MM_FTG256
U8: S27KS0642; BGA_24_6x8_DEPOP1_1MM

Connections:
/D1V8: C83.1, C84.1, C85.1, C86.1, R36.1, U8.B4 (VDD), U8.D1 (VDDQ), U8.E4 (VDDQ); also elsewhere on the board
/GND: C83.2, C84.2, C85.2, C86.2, R37.1, U8.B3 (VSS), U8.C1 (VSSQ), U8.E5 (VSSQ); also elsewhere on the board
/MCU_SPI_CS_N: U2.L5 (IO_0_34); also elsewhere on the board
/MCU_SPI_SCK: U2.L4 (IO_L1P_T0_34); also elsewhere on the board
/MCU_SPI_SI: U2.M4 (IO_L1N_T0_34); also elsewhere on the board
/MCU_SPI_SO: U2.M2 (IO_L2P_T0_34); also elsewhere on the board
/RAM/RAM_CLK_N: R34.2, U2.N1 (IO_L4P_T0_34), U8.B1 (CK_N)
/RAM/RAM_CLK_P: R34.1, U2.P1 (IO_L4N_T0_34), U8.B2 (CK_P)
/RAM/RAM_CS_N: R36.2, U2.N4 (IO_L6P_T0_34), U8.A3 (CS_N)
/RAM/RAM_DQ0: R14.2, U2.T2 (IO_L8N_T1_34)
/RAM/RAM_DQ1: R15.2, U2.T3 (IO_L9N_T1_DQS_34)
/RAM/RAM_DQ2: R16.2, U2.R1 (IO_L7N_T1_34)
/RAM/RAM_DQ3: R17.2, U2.P5 (IO_L10P_T1_34)
/RAM/RAM_DQ4: R18.2, U2.M5 (IO_L6P_T0_34)
/RAM/RAM_DQ5: R19.2, U2.R2 (IO_L7P_T1_34)
/RAM/RAM_DQ6: R20.2, U2.R3 (IO_L8P_T1_34)
/RAM/RAM_DQ7: R21.2, U2.T4 (IO_L9P_T1_DQS_34)
/RAM/RAM_DQS: R13.2, U2.N3 (IO_L3P_T0_DQS_34)
/RAM/RAM_PSC_N: R35.2, U2.P4 (IO_L5P_T0_34), U8.C5 (PSC_N)
/RAM/RAM_PSC_P: R35.1, U2.P3 (IO_L5N_T0_34), U8.B5 (PSC_P)
/RAM/RAM_RST_N: R37.2, U2.N2 (IO_L3N_T0_DQS_34), U8.A4 (RST_N)
/UWIRE_LEVELSHIFT_DIR: U2.M1 (IO_L2N_T0_34); also elsewhere on the board
unnamed: R13.1, U8.C3 (DQS)
unnamed: R14.1, U8.D3 (DQ0)
unnamed: R15.1, U8.D2 (DQ1)
unnamed: R16.1, U8.C4 (DQ2)
unnamed: R17.1, U8.D4 (DQ3)
unnamed: R18.1, U8.D5 (DQ4)
unnamed: R19.1, U8.E3 (DQ5)
unnamed: R20.1, U8.E2 (DQ6)
unnamed: R21.1, U8.E1 (DQ7)

Notes on the sheet:
Place test points in layout on CLK, PSC, DQS, and at least one DQ line
Both clocks inverted for routing

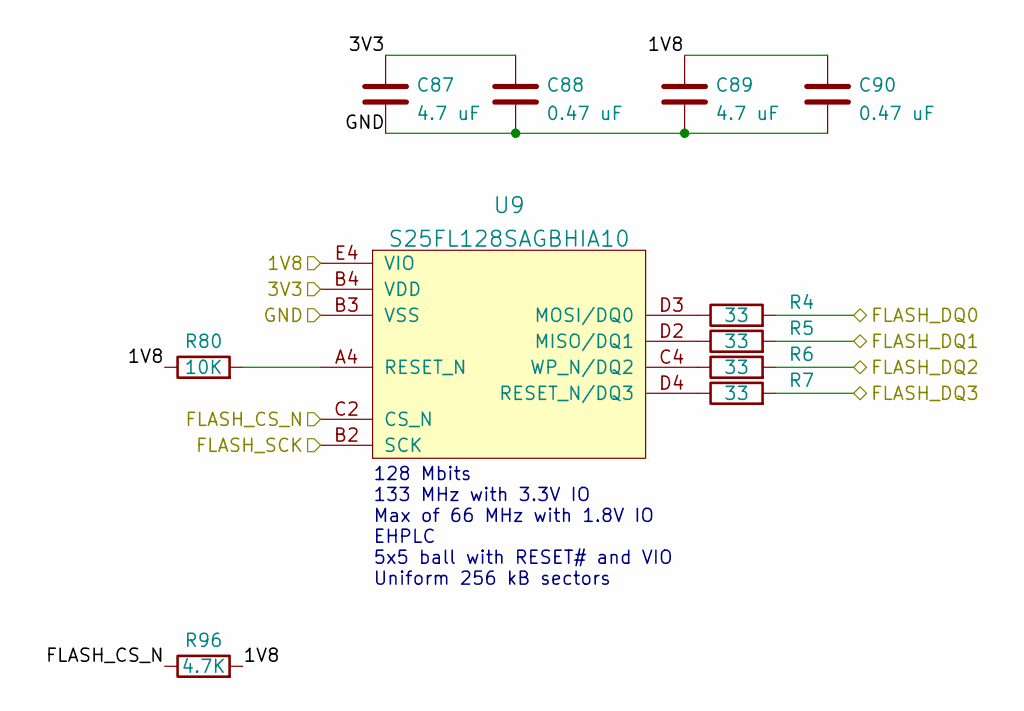
[picture p9: schematic flash.kicad_sch, Digitizer board]

Parts:
C87, C89: 4.7 uF; EIA_0603_CAP_NOSILK
C88, C90: 0.47 uF; EIA_0402_CAP_NOSILK
R4, R5, R6, R7: 33; EIA_0402_RES_NOSILK
R80: 10K; EIA_0402_RES_NOSILK
R96: 4.7K; EIA_0402_RES_NOSILK
U9: S25FL128SAGBHIA10; BGA_24_6x8_DEPOP1_1MM

Connections:
/3V3: C87.1, C88.1, U9.B4 (VDD); also elsewhere on the board
/ADCs/FLASH_DQ0: R4.2; also elsewhere on the board
/ADCs/FLASH_DQ1: R5.2; also elsewhere on the board
/ADCs/FLASH_DQ2: R6.2; also elsewhere on the board
/ADCs/FLASH_DQ3: R7.2; also elsewhere on the board
/D1V8: C89.1, C90.1, R80.1, R96.2, U9.E4 (VIO); also elsewhere on the board
/FPGA support/FLASH_SCK: U9.B2 (SCK); also elsewhere on the board
/GND: C87.2, C88.2, C89.2, C90.2, U9.B3 (VSS); also elsewhere on the board
/QSPI flash/FLASH_CS_N: R96.1, U9.C2 (CS_N); also elsewhere on the board
unnamed: R4.1, U9.D3 (MOSI/DQ0)
unnamed: R5.1, U9.D2 (MISO/DQ1)
unnamed: R6.1, U9.C4 (WP_N/DQ2)
unnamed: R7.1, U9.D4 (RESET_N/DQ3)
unnamed: R80.2, U9.A4 (RESET_N)

Notes on the sheet:
128 Mbits 133 MHz with 3.3V IO Max of 66 MHz with 1.8V IO EHPLC 5x5 ball with RESET# and VIO Uniform 256 kB sectors

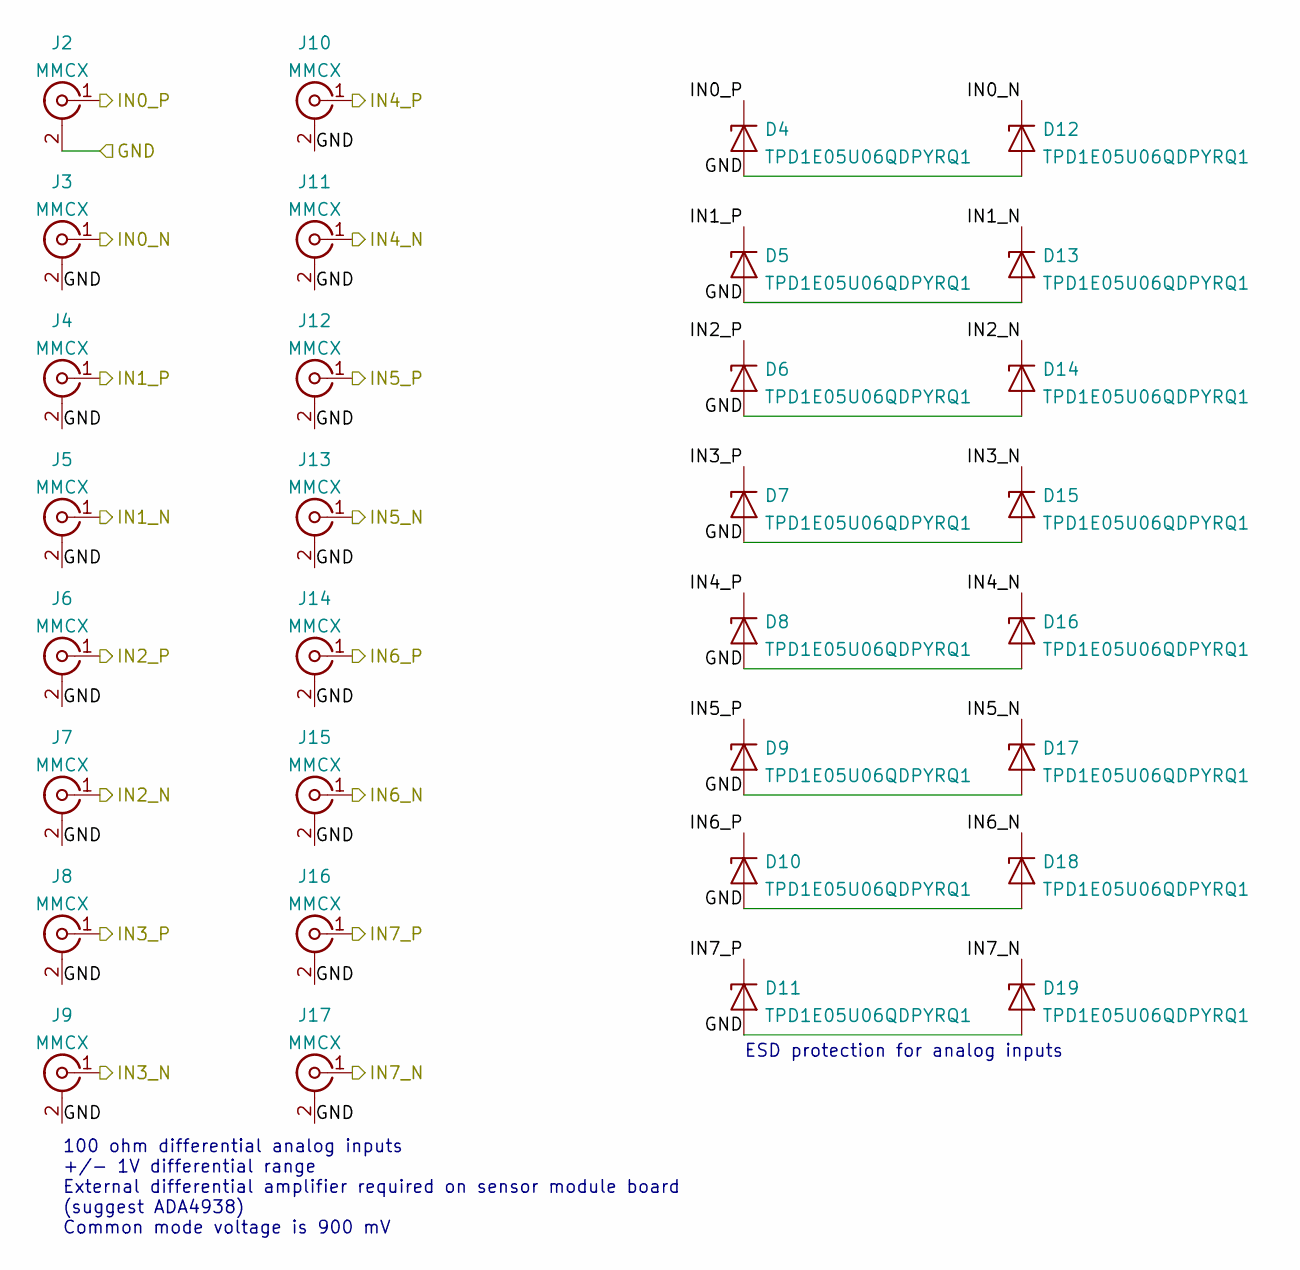
[picture p10: schematic afes.kicad_sch, Digitizer board]

Parts:
D4, D5, D6, D7, D8, D9, D10, D11, D12, D13, D14, D15, D16, D17, D18, D19: TPD1E05U06QDPYRQ1; DFN_2_1x0.6_TI_DPY
J2, J3, J4, J5, J6, J7, J8, J9, J10, J11, J12, J13, J14, J15, J16, J17: MMCX; CONN_MMCX_J_P_H_ST_EM1

Connections:
/ADCs/IN0_N: D12.1 (K), J3.1 (In); also elsewhere on the board
/ADCs/IN0_P: D4.1 (K), J2.1 (In); also elsewhere on the board
/ADCs/IN1_N: D13.1 (K), J5.1 (In); also elsewhere on the board
/ADCs/IN1_P: D5.1 (K), J4.1 (In); also elsewhere on the board
/ADCs/IN2_N: D14.1 (K), J7.1 (In); also elsewhere on the board
/ADCs/IN2_P: D6.1 (K), J6.1 (In); also elsewhere on the board
/ADCs/IN3_N: D15.1 (K), J9.1 (In); also elsewhere on the board
/ADCs/IN3_P: D7.1 (K), J8.1 (In); also elsewhere on the board
/ADCs/IN4_N: D16.1 (K), J11.1 (In); also elsewhere on the board
/ADCs/IN4_P: D8.1 (K), J10.1 (In); also elsewhere on the board
/ADCs/IN5_N: D17.1 (K), J13.1 (In); also elsewhere on the board
/ADCs/IN5_P: D9.1 (K), J12.1 (In); also elsewhere on the board
/ADCs/IN6_N: D18.1 (K), J15.1 (In); also elsewhere on the board
/ADCs/IN6_P: D10.1 (K), J14.1 (In); also elsewhere on the board
/ADCs/IN7_N: D19.1 (K), J17.1 (In); also elsewhere on the board
/ADCs/IN7_P: D11.1 (K), J16.1 (In); also elsewhere on the board
/GND: D4.2 (A), D5.2 (A), D6.2 (A), D7.2 (A), D8.2 (A), D9.2 (A), D10.2 (A), D11.2 (A), D12.2 (A), D13.2 (A), D14.2 (A), D15.2 (A), D16.2 (A), D17.2 (A), D18.2 (A), D19.2 (A), J2.2 (Ext), J3.2 (Ext), J4.2 (Ext), J5.2 (Ext), J6.2 (Ext), J7.2 (Ext), J8.2 (Ext), J9.2 (Ext), J10.2 (Ext), J11.2 (Ext), J12.2 (Ext), J13.2 (Ext), J14.2 (Ext), J15.2 (Ext), J16.2 (Ext), J17.2 (Ext); also elsewhere on the board

Notes on the sheet:
100 ohm differential analog inputs +/- 1V differential range External differential amplifier required on sensor module board (suggest ADA4938) Common mode voltage is 900 mV
ESD protection for analog inputs

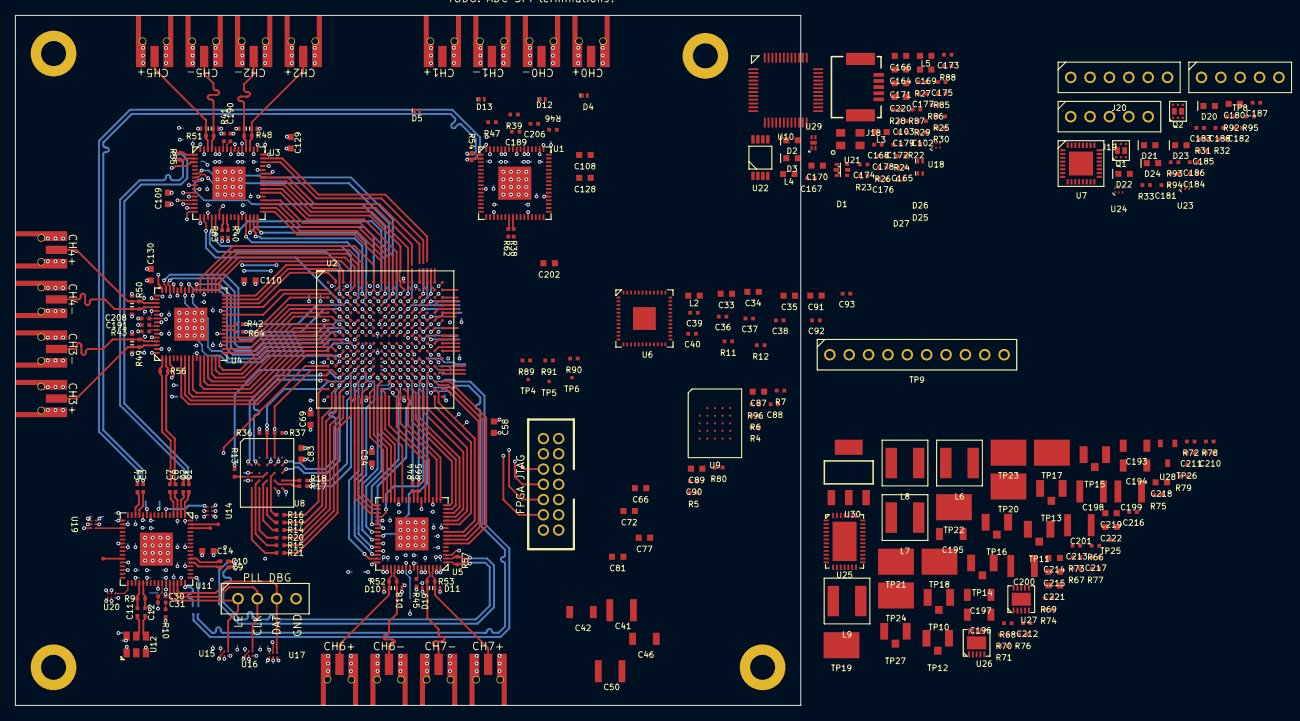
[picture p11: board acquisition.kicad_pcb from above]

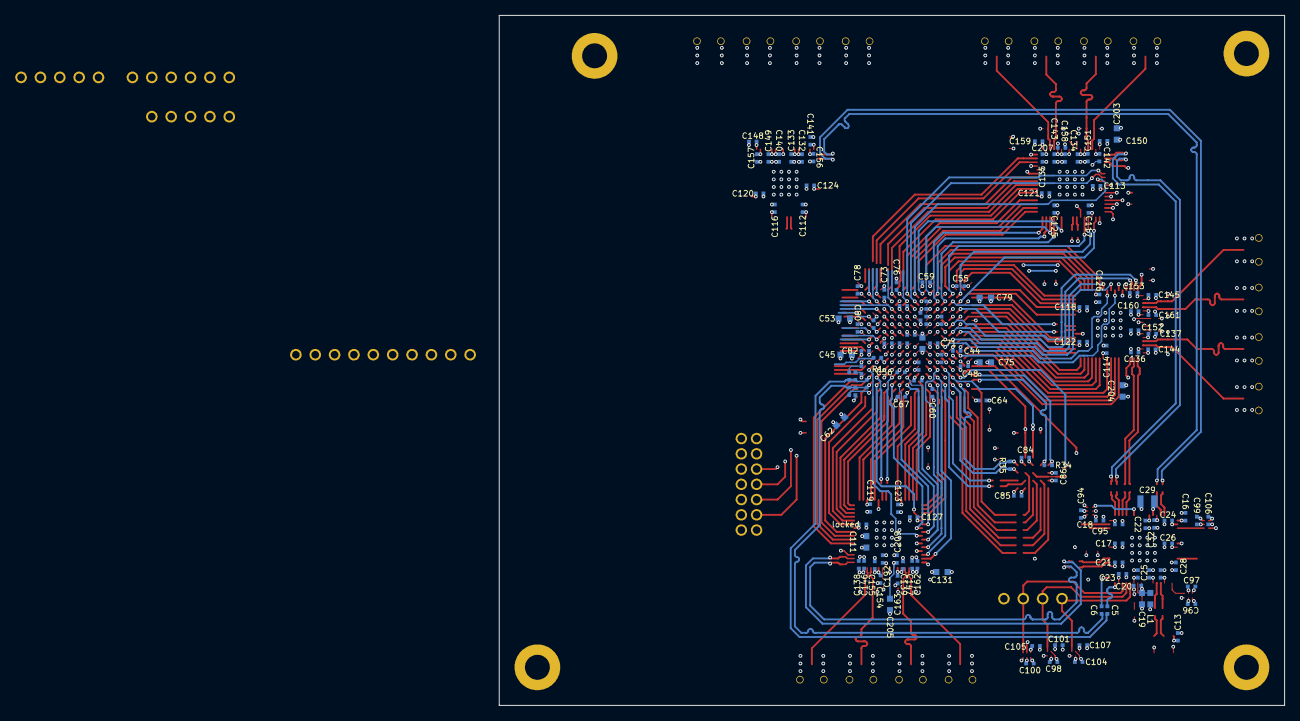
[picture p12: board acquisition.kicad_pcb from below]

Board: 6 copper layers, 103.0 x 90.5 mm, 432 parts (132 on the bottom side), 367 nets.

Other parts of the board:
locked: 0.47 uF; EIA_0402_CAP_NOSILK

Their connections:
/D1V8: locked.1; also elsewhere on the board
/GND: locked.2; also elsewhere on the board
