ammolytics/ballistic-daq/(commit log)

2022-06-21 Initial schematic skeleton
    [acquisition.kicad_pcb, acquisition.kicad_sch, adcs.kicad_sch, afes.kicad_sch, clocking.kicad_sch, flash.kicad_sch, fpgasupport.kicad_sch, mcu.kicad_sch]
2022-06-23 Continued initial design
    [acquisition.kicad_sch, adcs.kicad_sch, afes.kicad_sch, clocking.kicad_sch, flash.kicad_sch, fpgasupport.kicad_sch, ftdi.kicad_sch, mcu.kicad_sch]
2022-07-05 Updated schematic with a lot of level shifting and support stuff, power decoupling, etc. Almost done except power supply and protection diodes
    [acquisition.kicad_sch, adcs.kicad_sch, afes.kicad_sch, clocking.kicad_sch, flash.kicad_sch, fpgasupport.kicad_sch, ftdi.kicad_sch, mcu.kicad_sch]
2022-07-06 Lots of progress on power supply design, added a bunch of test points, etc
    [acquisition.kicad_sch, adcs.kicad_sch, afes.kicad_sch, clocking.kicad_sch, flash.kicad_sch, fpgasupport.kicad_sch, ftdi.kicad_sch, mcu.kicad_sch]
2022-07-08 More power supply work, added PLL loop filter, soft start, began assigning footprints
    [acquisition.kicad_pcb, acquisition.kicad_sch, adcs.kicad_sch, afes.kicad_sch, clocking.kicad_sch, flash.kicad_sch, fpgasupport.kicad_sch, ftdi.kicad_sch]
2022-07-17 Completed schematic after design review, ready for layout
    [acquisition.kicad_sch, adcs.kicad_sch, afes.kicad_sch, clocking.kicad_sch, flash.kicad_sch, fpgasupport.kicad_sch, ftdi.kicad_sch, mcu.kicad_sch]
2023-01-30 Finished footprint assignment
    [acquisition.kicad_pcb, acquisition.kicad_sch, adcs.kicad_sch, afes.kicad_sch, clocking.kicad_sch, flash.kicad_sch, fpgasupport.kicad_sch, ftdi.kicad_sch]
2023-01-30 Initial layout floorplanning
    [acquisition.kicad_pcb]
2023-01-31 Finished initial routing of RAM, hooked up almost all of first ADC
    [acquisition.kicad_pcb, acquisition.kicad_sch, adcs.kicad_sch, ram.kicad_sch]
2023-01-31 Continued layout of bottom ADC, routed FPGA JTAG
    [acquisition.kicad_pcb, acquisition.kicad_sch, adcs.kicad_sch, afes.kicad_sch, clocking.kicad_sch, flash.kicad_sch, fpgasupport.kicad_sch, ftdi.kicad_sch]
2023-02-01 Began layout of clocking subsystem
    [acquisition.kicad_pcb, acquisition.kicad_sch, adcs.kicad_sch, afes.kicad_sch, clocking.kicad_sch, flash.kicad_sch, fpgasupport.kicad_sch, ftdi.kicad_sch]
2023-02-02 Continued layout of clocking subsystem, second ADC, and BGA fanout
    [acquisition.kicad_pcb, adcs.kicad_sch, clocking.kicad_sch]
2023-02-03 Hooked up power and analog connections to third ADC, no data bus yet
    [acquisition.kicad_pcb, acquisition.kicad_sch, adcs.kicad_sch, afes.kicad_sch, clocking.kicad_sch, flash.kicad_sch, fpgasupport.kicad_sch, ftdi.kicad_sch]
2023-02-04 Routed most of third ADC data bus
    [acquisition.kicad_pcb, adcs.kicad_sch]
2023-02-04 Fully routed ADC #3
    [acquisition.kicad_pcb, adcs.kicad_sch]
2023-02-04 Initial placement and power/clock routing for fourth ADC
    [acquisition.kicad_pcb]
